ParagPat20/Codes/Documentation/PatentFile.md

# **Design Patent Synopsis for Rollopod – A Transforming Hexapod Robot**

## **Title of the Design**  
**Rollopod – A Transforming Hexapod with Dual-Mode Locomotion**

## **1st Applicant Information**  
- **Name:** Parag Patil  
- **Address:** 10-C, Aakarpark Society, Near Parth colony, Vijalpore, Navsari, Gujarat, India - 396445  
- **Contact Details:** 9313552445  

## **2nd Applicant Information**  
- **Name:** Rutu Patel  
- **Address:** 10-C, Aakarpark Society, Near Parth colony, Vijalpore, Navsari, Gujarat, India - 396445  
- **Contact Details:** 9313552445  

## **Field of Invention**  
The present design pertains to robotic locomotion systems, specifically a **hexapod robot capable of dual-mode movement – walking and rolling** – with a **unique transformation mechanism**. The design enables efficient **mobility, stability, and adaptability**, making it suitable for applications in **search and rescue, planetary exploration, industrial inspection, military operations, and autonomous mobility solutions**.  

Rollopod is not a spherical robot. It is a dual-ring transformable hexapod with a central suspended body where three legs on each side transform into a wheel.

## **Physical Architecture**
Rollopod consists of:
- One central body module.
- Three legs on each side transform into a wheel.
- Three articulated legs mounted on the left ring.
- Three articulated legs mounted on the right ring.
- Six legs total.

The rolling rings remain visible in all operating modes.
The central body remains suspended between the two rolling rings.
The robot never transforms into a sphere.

## **Transformation Mechanism**

Walking Mode:
- Six legs fully extended.
- Three legs on each side.
- Robot operates as a hexapod.

Rolling Mode:
- Left legs fold into left rolling ring.
- Right legs fold into right rolling ring.
- Folded legs become part of the rolling structure.
- Two rolling rings provide locomotion.

During transformation:
- Central body remains visible.
- Central body remains suspended.
- No spherical enclosure is formed.

### Transformation States
Rollopod can exist in:

1. **Walking State**
   - All six legs deployed.

2. **Rolling State**
   - Both side rings closed.

3. **Transitional State**
   - One or more legs partially folded.
   - One ring may be deployed while the opposite ring remains closed.
   - Intermediate configurations are mechanically valid and visually important.

## **Description of the Design**  
The **Rollopod** features a **six-legged walking system** integrated with a **rotational mechanism** that enables the robot to transition smoothly between rolling and walking. The unique **geometric configuration of its legs, outer disk, and actuators** allows a **compact dual-ring rolling configuration for rolling** and an **expanded form for hexapod walking**. The design also incorporates **speed differential control** for movement direction during rolling mode.  

### **Key Novel Design Features**  
1. **Transformation Mechanism:**  
   - Uses a **servo-actuated unfolding system** to switch modes dynamically.  

2. **Aesthetics and Structural Form:**  
   - The **symmetrical leg arrangement** ensures both **walking stability** and **rolling efficiency**.  
   - **Outer disk structure** facilitates smooth rolling motion while maintaining a sleek robotic profile.  

3. **Speed Differential Control for Rolling Movement:**  
   - The design employs **independent speed control of the rolling disks** to enable **forward, backward, and directional movement** without additional steering components.  

4. **Material and Build Innovation:**  
   - **Lightweight aluminum or carbon fiber** frame enhances durability while reducing energy consumption.  
   - **Integrated gear, servo mechanisms, and distributed electronics (ESP32 microcontrollers and PCA9685 PWM drivers)** ensure seamless wireless actuation within the rolling disk while maintaining a compact and efficient form.  

### Structural Novelty
The Rollopod architecture consists of:
- Three legs on each side transform into a wheel.
- One central suspended body.
- Three articulated legs integrated into each rolling ring.

The transformation mechanism allows the legs to fold into the side rolling rings while maintaining visibility of the central body.
The robot maintains a dual-ring geometry throughout transformation and operation.

## **Statement of Novelty**  
The **Rollopod's** design is a **first-of-its-kind robotic structure** integrating **hexapod walking with a rolling transformation system**, while maintaining an **aesthetically distinct and functionally efficient form**. The **side-ring rolling configuration, servo-actuated transformation mechanism, and speed differential movement control** contribute to its **unique and non-obvious design elements**.  

## **Claimed Design Aspects**  
1. **Overall Shape and Transformation Design** – The **unique ability to shift from a hexapod to a dual-wheel rolling robot** while maintaining **functional stability and aesthetics**.  
2. **Leg Mechanism Integration** – A **foldable six-legged system** that fully retracts into a **circular rolling frame**, forming a **streamlined and compact appearance**.  
3. **Rolling Frame with Integrated Actuation** – A **servo-driven disk system** providing **seamless and controlled rolling movement** using **speed differential for directional control**.  
4. **Overall Structural Appearance** – A distinctive **dual-mode robotic form**, aesthetically optimized for both mobility and durability.  

## **Illustrations & Views**  
Attached to this application are **detailed drawings, CAD models, and exploded views** showcasing:  
1. **Isometric View of the Hexapod Mode**  
2. **Isometric View of the Rolling Mode**  
3. **Front, Side, and Top Views of Both Configurations**  
4. **Transformation Sequence Diagrams**  
5. **Functional Component Integration with Structural Elements**  
6. **Additional Views and Uploaded Files:**  
   - All Views  
   - Front View  
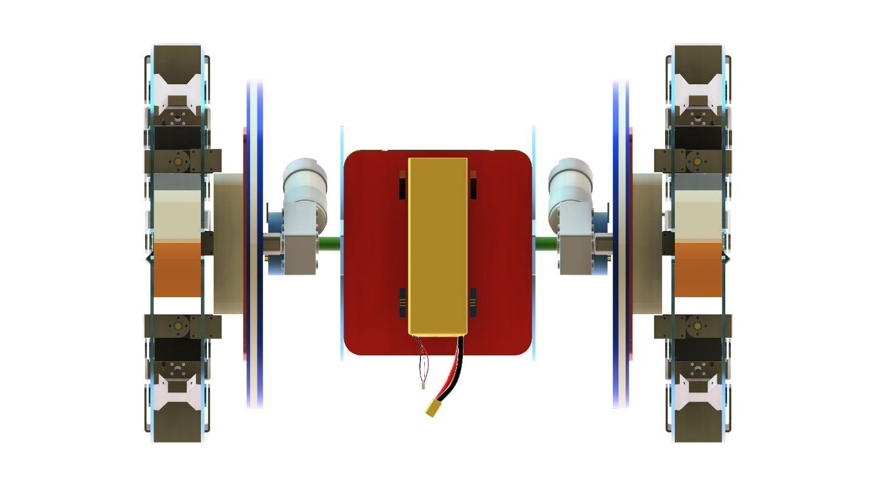
[picture p5: BottomView.png]
Bottom View
   -   
   - Left View  
   - Right View  
   - Home View  

## **Conclusion**  
This **design patent application for Rollopod** seeks protection for its **unique dual-mode robotic structure**, ensuring exclusive rights over its **visual and structural innovations**. The design presents a **novel aesthetic and functional combination** that enhances **robotic mobility across varied terrains and applications**.
