ParagPat20/Codes/Hardware_Design/KiBee/KiBee_V0_Documentation.docx

KiBee V0

Compact AI Home Robot

Product & Engineering Documentation

Version 0.1 • July 2026 • Derived from the Rollopod Platform

# 1. Overview

KiBee V0 is a compact AI home robot derived from Rollopod’s rolling-mode architecture. Instead of transforming into a walking hexapod, KiBee permanently remains in the dual-wheel rolling configuration, creating a smaller, faster, quieter, and more practical indoor companion robot.

It is essentially the first consumer product built on the Rollopod platform.

KiBee inherits the core mechanical advantages of Rollopod’s suspended central body and dual independently driven rolling rings while eliminating the complexity, weight, cost, and maintenance associated with legged transformation. The result is a highly reliable, low-cost indoor mobility platform optimised for AI interaction, voice assistance, and autonomous navigation inside homes, offices, schools, and laboratories.

# 2. Core Philosophy

Instead of designing a robot with legs, take Rollopod’s rolling mode and redesign it as a home robot.

Key advantages of this approach:

- Extremely stable – low centre of gravity and wide dual-wheel base
- High speed indoors on flat surfaces (tiles, wood, carpet)
- Simple mechanics – no transformation linkages or multi-DOF leg joints
- Lower manufacturing cost and bill of materials
- Lower power consumption and longer battery life
- Much higher reliability than legged or multi-mode robots

# 3. Relationship with Rollopod

KiBee is not a separate mobility concept. It is a direct derivative of Rollopod’s rolling architecture:

- Rollopod: Dual-mode robot (walking + rolling) for outdoor, rough-terrain, disaster-response, and research applications.
- KiBee: Permanently configured in Rollopod’s rolling mode, optimised for indoor environments, human interaction, and AI assistance.

This approach lets KiBee inherit Rollopod’s compact suspended-body geometry, stability, differential-drive rolling mechanism, and proven bearing isolation concept while removing the entire walking transformation subsystem. The same engineering DNA therefore serves two distinct product lines: a rugged field research platform (Rollopod) and a consumer indoor companion (KiBee).

# 4. Mechanical Architecture

## 4.1 Chassis

KiBee uses a fixed dual-ring rolling chassis derived directly from Rollopod’s rolling state:

- Two side rolling rings (permanently closed configuration)
- Central suspended body / payload pod
- Precision bearing interfaces isolating the body from ring rotation
- Same balancing and low-centre-of-gravity concept as Rollopod
- No walking transformation – legs are never deployed

The robot never deploys legs. The rolling rings are permanent structural wheels, not transformed leg assemblies. This dramatically simplifies the mechanical design, reduces part count, and improves long-term reliability for continuous indoor use.

## 4.2 Locomotion

Primary locomotion is dual independently driven wheels with differential steering:

- Two DC geared motors, one per ring
- Differential drive enabling forward, reverse, and zero-radius turning
- Suitable for tiles, wooden floors, offices, homes, schools, and laboratories
- Quiet, smooth, and energy-efficient continuous motion

## 4.3 Central Body

The central suspended body houses all major electronics and interaction components:

- Raspberry Pi 5 (main AI & navigation computer)
- Battery pack and power management
- Speakers and microphone array
- Camera (vision / face detection / navigation)
- Display (status / facial expressions / UI)
- IMU, sensors, and secondary controller (ESP32)

The body remains suspended between the two wheels exactly as in Rollopod, preserving the stable, forward-facing sensor and interaction orientation at all times.

# 5. Appearance & Industrial Design

KiBee is designed as a friendly, compact, rounded consumer electronics product rather than an industrial or research prototype.

Visual and emotional targets:

- Friendly and approachable
- Compact and low-profile
- Rounded soft forms
- Consumer electronics aesthetic (not industrial or military)
- Emotional reference mix: Samsung Ballie + Amazon Astro + Loona, but mechanically grounded in Rollopod’s dual-ring geometry

The industrial design prioritises safety for household use (no sharp edges, soft contact surfaces where possible) while retaining the distinctive dual-wheel silhouette that communicates stability and mobility.

# 6. Electronics Architecture

## 6.1 Main Processor – Raspberry Pi 5

The Raspberry Pi 5 serves as the high-level brain responsible for:

- AI inference and conversational assistance
- Computer vision (navigation, face detection, obstacle awareness)
- Audio processing and voice interaction
- User interface and display rendering
- Networking (Wi-Fi, remote control, cloud services)

## 6.2 Secondary Controller – ESP32

A dedicated ESP32 handles real-time, safety-critical, and low-level tasks:

- Motor control (PWM / driver interface)
- Battery monitoring and power management
- IMU reading and basic orientation feedback
- Encoder feedback (if fitted)
- Safety interlocks and emergency stop logic

This distributed architecture mirrors the reliable master/slave + real-time actuator separation proven on Rollopod, adapted for a simpler two-motor indoor platform.

## 6.3 Mobility Hardware

Two DC geared motors with appropriate motor drivers, an IMU for tilt and motion sensing, and optional wheel encoders form the complete mobility subsystem. Power is distributed with isolation between logic and high-current motor rails, following the same reliability principles established on the Rollopod platform.

# 7. KiBee V0 Feature Set

The initial V0 release focuses on core indoor companion capabilities:

Feature | Description
Autonomous Movement | Self-directed navigation on flat indoor surfaces with obstacle awareness
AI Assistant | On-device and/or cloud-assisted conversational AI for general help, reminders, and information
Voice Interaction | Far-field microphone array and speaker system for natural voice commands and responses
Indoor Navigation | Map building / localisation suitable for homes, offices, and classrooms
Remote Control | App or web-based remote operation and monitoring

# 8. Target Environments & Use Cases

KiBee V0 is optimised for controlled indoor environments:

1. Homes – family companion, elderly assistance, pet monitoring, smart-home hub
2. Offices – visitor greeting, meeting-room assistance, delivery of small items
3. Schools & Laboratories – educational platform, interactive learning companion
4. Retail / hospitality – customer guidance and information (future expansion)

# 9. Development Status (V0)

KiBee V0 is the first consumer-oriented product derived from the mature Rollopod mechanical and control research. Current status emphasises:

Completed / Inherited

- Dual-ring rolling geometry and suspended-body concept (from Rollopod)
- Differential-drive motor architecture principles
- Distributed control philosophy (high-level Pi + real-time ESP32)

In Progress / V0 Focus

- Consumer-grade enclosure and industrial design
- Raspberry Pi 5 software stack (AI, vision, voice, navigation)
- Simplified two-motor drive electronics and battery system
- Safety certification and indoor usability testing

# 10. Summary

KiBee V0 represents the first commercialisation path of the Rollopod platform. By permanently locking the robot into its most efficient locomotion mode—dual-wheel differential rolling—and wrapping that proven geometry in a friendly consumer form factor with modern AI capabilities, KiBee delivers a practical, reliable, and cost-effective indoor companion robot.

The project maintains a clear technical lineage: Rollopod’s research into hybrid locomotion and suspended-body stability directly enables KiBee’s simplicity and robustness. Future iterations can continue to share mechanical and control IP between the outdoor research platform and the indoor consumer product line.

KiBee V0 – Rollopod’s rolling heart, reborn as a home companion.

Document Control

Title: KiBee V0 – Product & Engineering Documentation

Version: 0.1 (Initial)

Date: July 2026

Derived from: Rollopod Platform (Parag Patil • Rutu Patel • Parul University)

Status: Living document – update as mechanical and software prototypes progress

Confidential • Page • Derived from Rollopod Platform

KiBee V0 | Product & Engineering Documentation
