ParagPat20/Codes/Documentation/Photos.docx

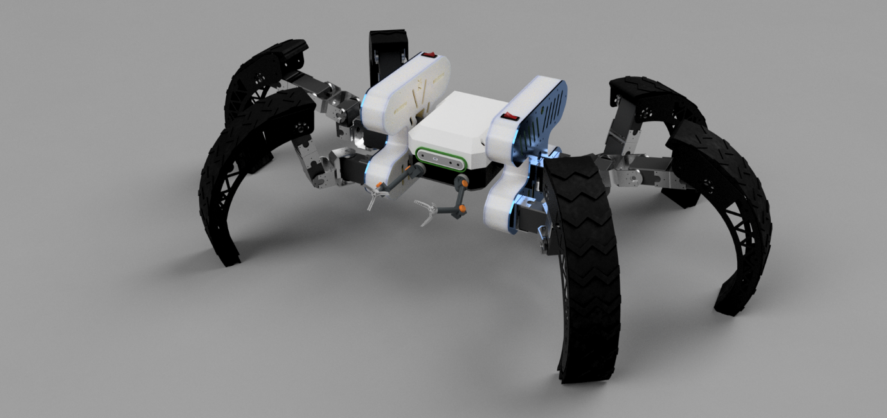
[picture p44: figure]
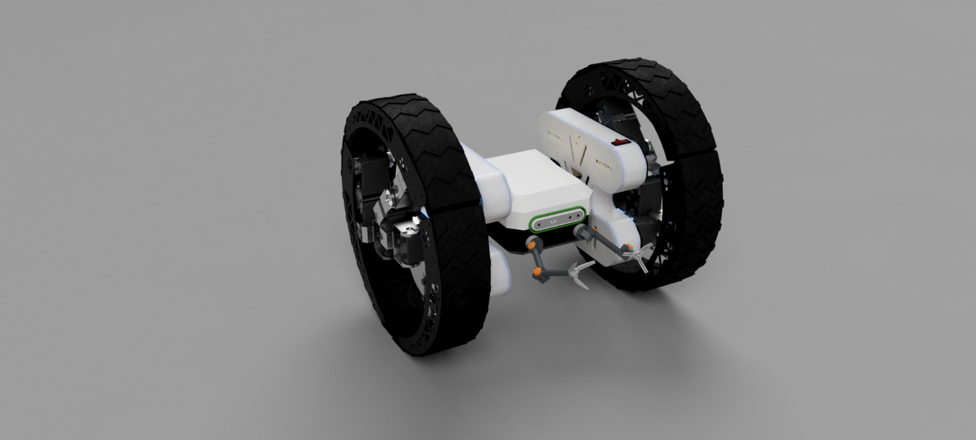
[picture p45: figure]
