ParagPat20/Codes/Firmware/LCD_1_69_BASE/source.gif

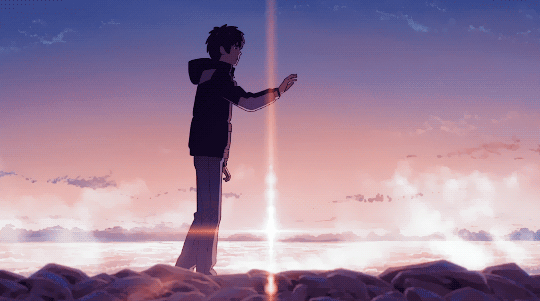
Firmware/LCD_1_69_BASE/source.gif
