ParagPat20/Codes/Hardware_Design/KiBee/7c71ced0-1b35-460e-97a9-f4f10c7d7b67.png

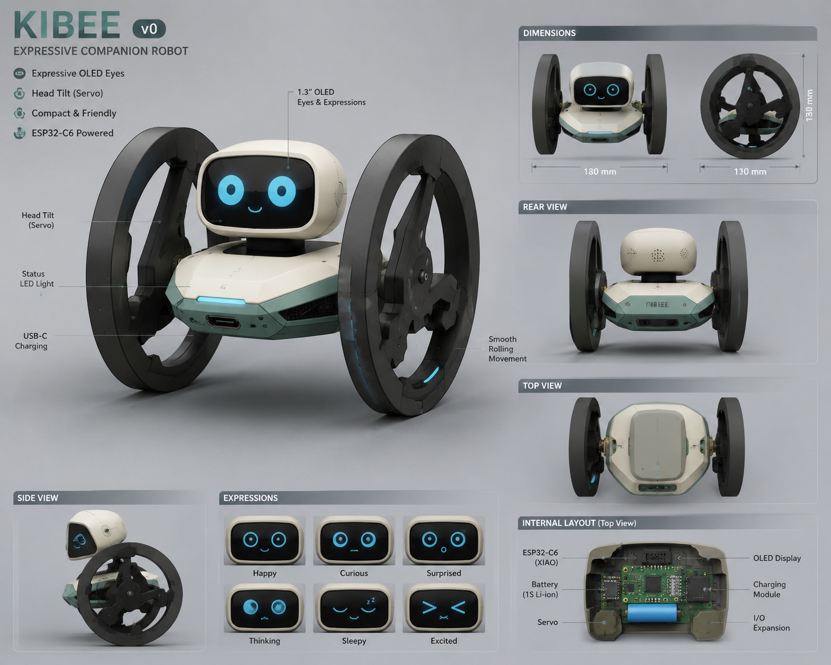
Hardware_Design/KiBee/7c71ced0-1b35-460e-97a9-f4f10c7d7b67.png
