ParagPat20/Codes/Hardware_Design/KiBee/51fc863d-131d-4990-9c5d-91c019468618.png

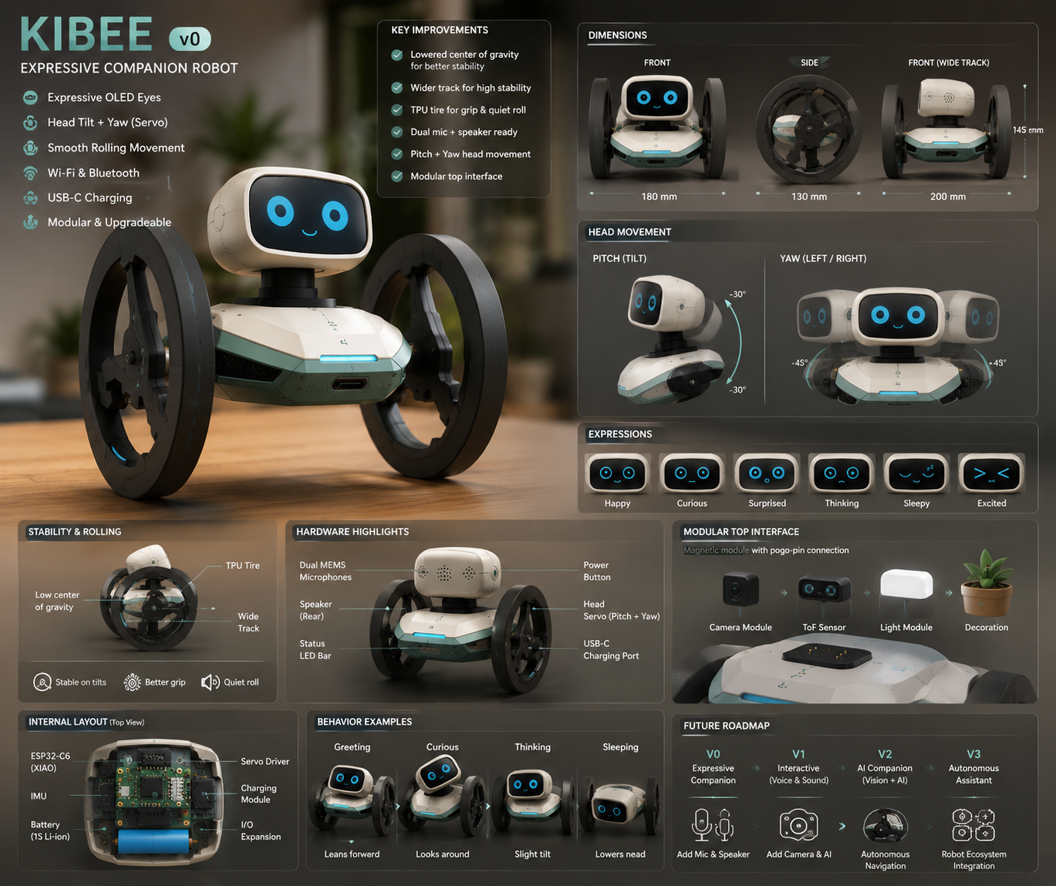
Hardware_Design/KiBee/51fc863d-131d-4990-9c5d-91c019468618.png
