ParagPat20/Codes/Hardware_Design/KiBee/FrontVierw.png

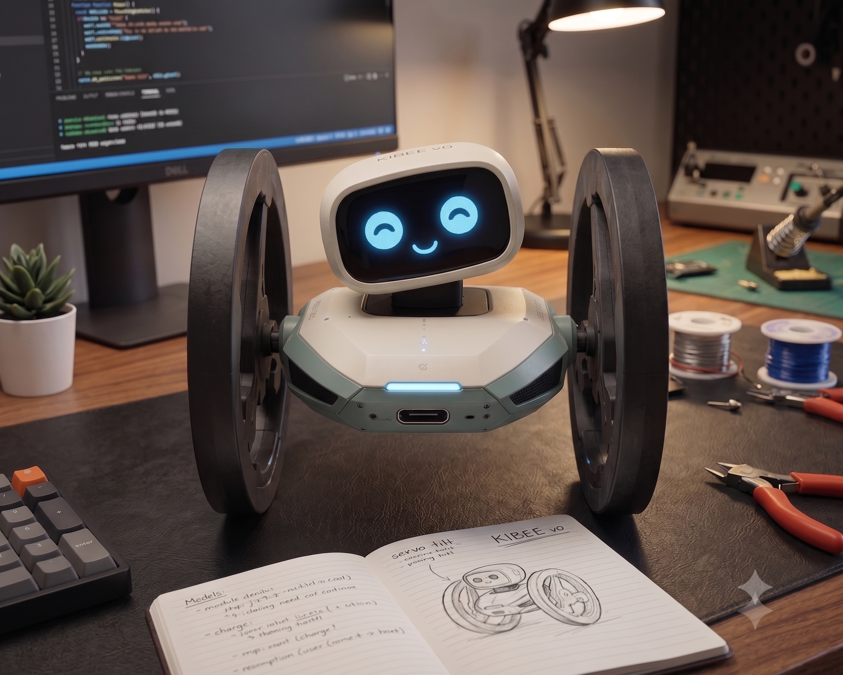
Hardware_Design/KiBee/FrontVierw.png
