ParagPat20/Codes/Hardware_Design/KiBee/Gemini_Generated_Image_ich2xvich2xvich2.png

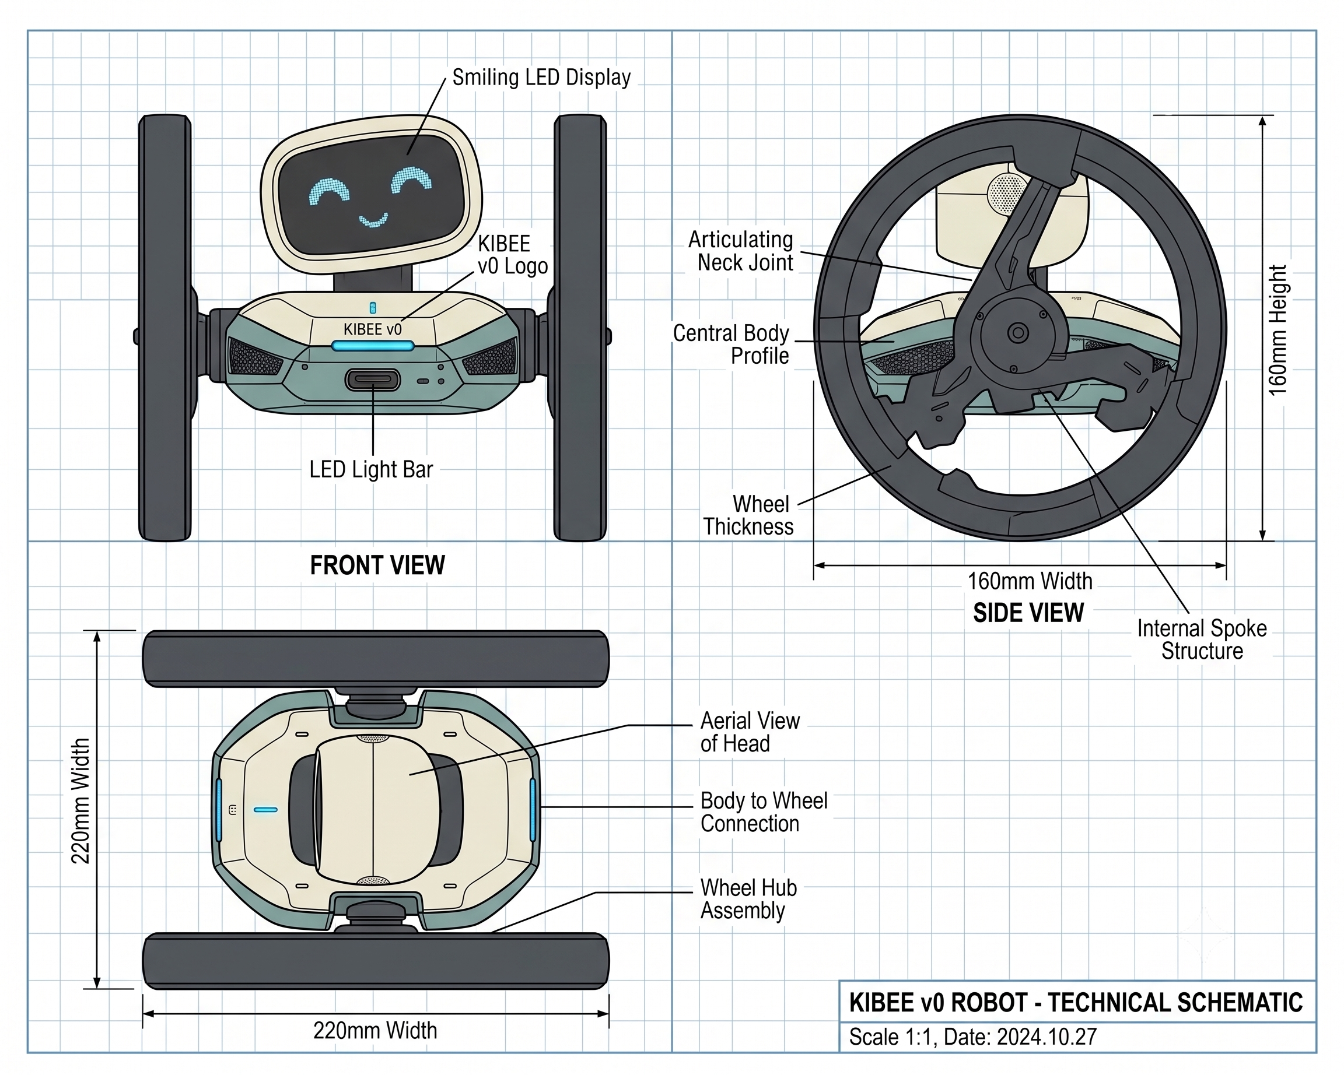
Hardware_Design/KiBee/Gemini_Generated_Image_ich2xvich2xvich2.png
