ParagPat20/Codes/Hardware_Design/KiBee/Gemini_Generated_Image_mz15chmz15chmz15.png

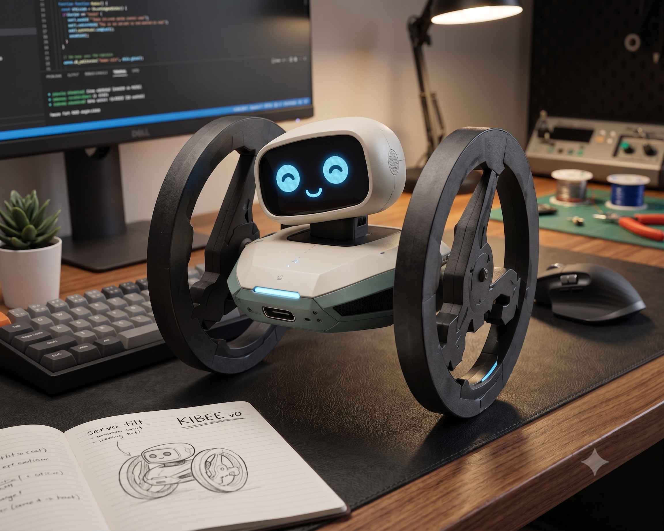
Hardware_Design/KiBee/Gemini_Generated_Image_mz15chmz15chmz15.png
