ParagPat20/Codes/Hardware_Design/KiBee/SideView.png

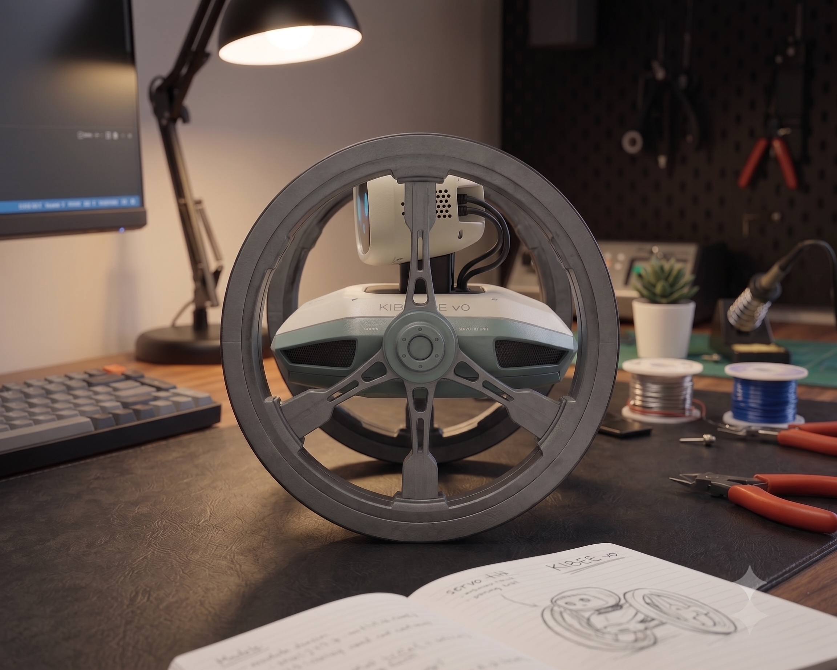
Hardware_Design/KiBee/SideView.png
