ParagPat20/Codes/Hardware_Design/KiBee/TopView.png

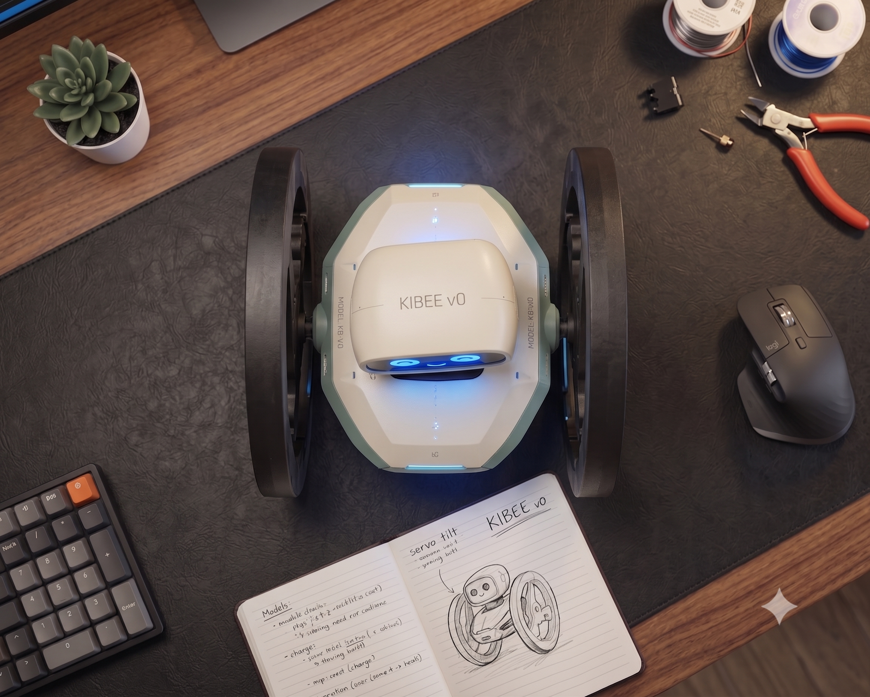
Hardware_Design/KiBee/TopView.png
