ParagPat20/Codes/Hardware_Design/Schematics/PCB_PCB_Rollopod_2_2026-06-08.png

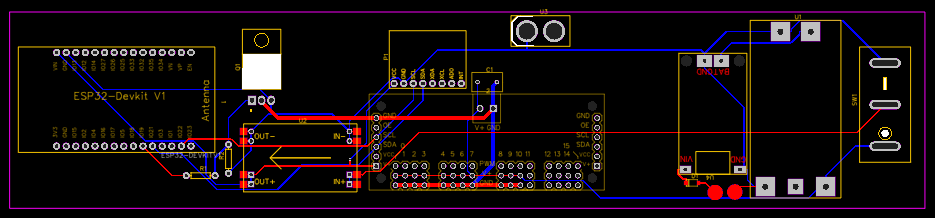
Hardware_Design/Schematics/PCB_PCB_Rollopod_2_2026-06-08.png
