ParagPat20/Codes/Hardware_Design/Schematics/Schematic_Rollopod_2026-06-08.png

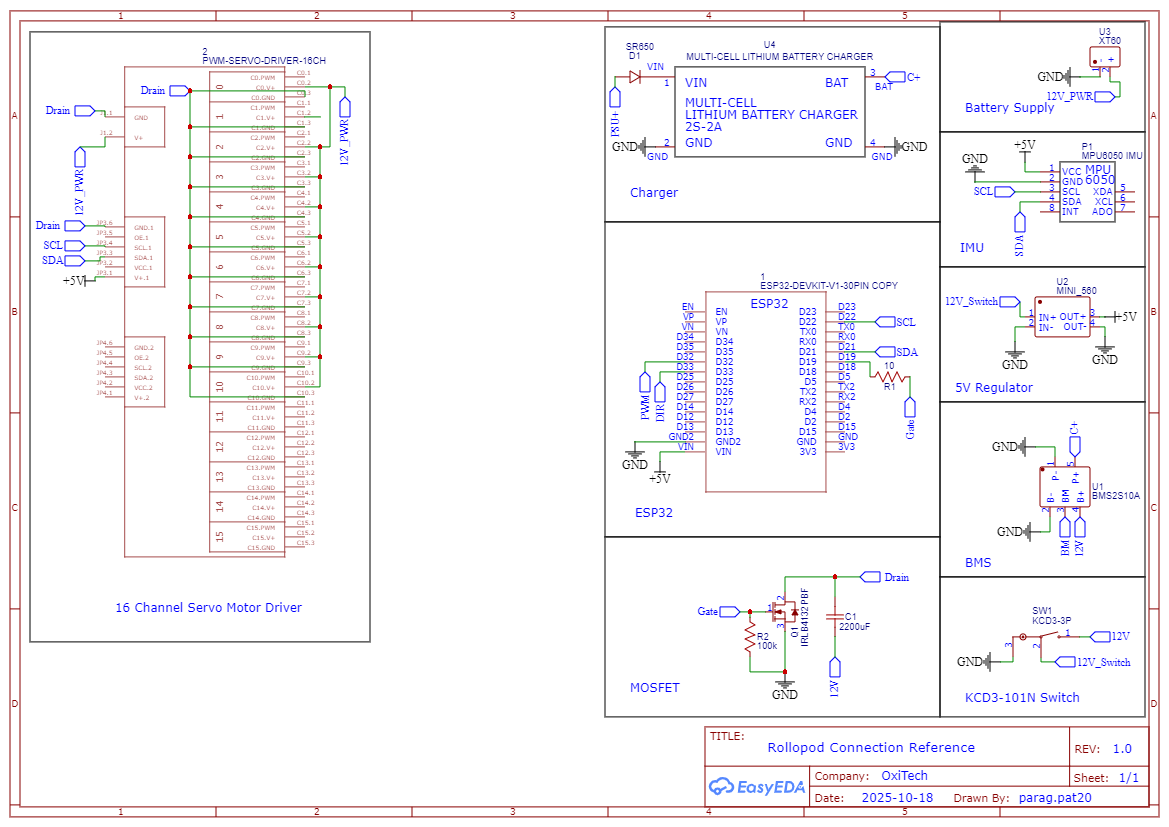
Hardware_Design/Schematics/Schematic_Rollopod_2026-06-08.png
