ParagPat20/Codes/Scripts/extracted_images/image7.jpg

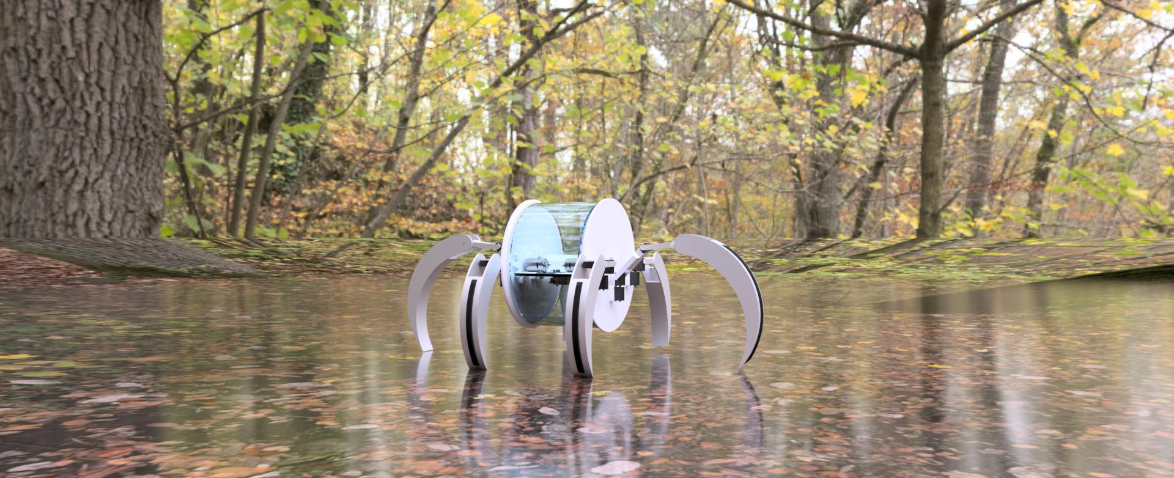
Scripts/extracted_images/image7.jpg
