ParagPat20/Codes/Scripts/extracted_images/image9.jpg

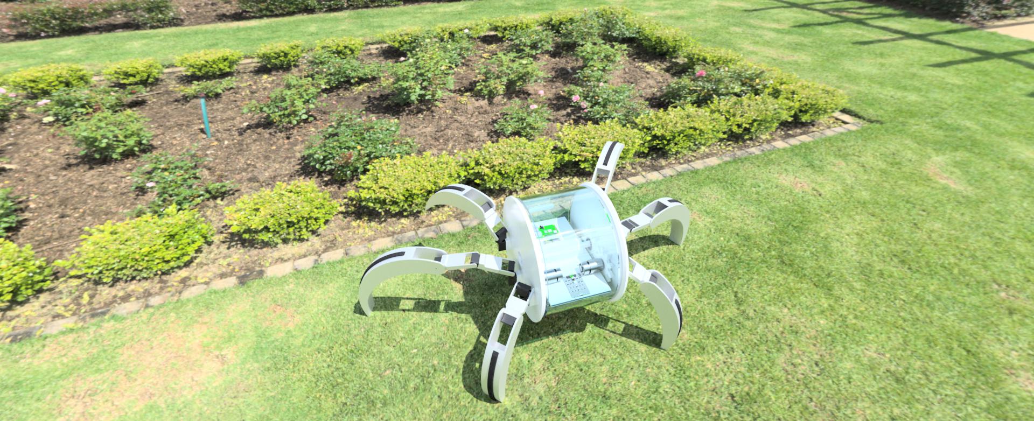
Scripts/extracted_images/image9.jpg
