ParagPat20/Codes/Scripts/extracted_images/image10.png

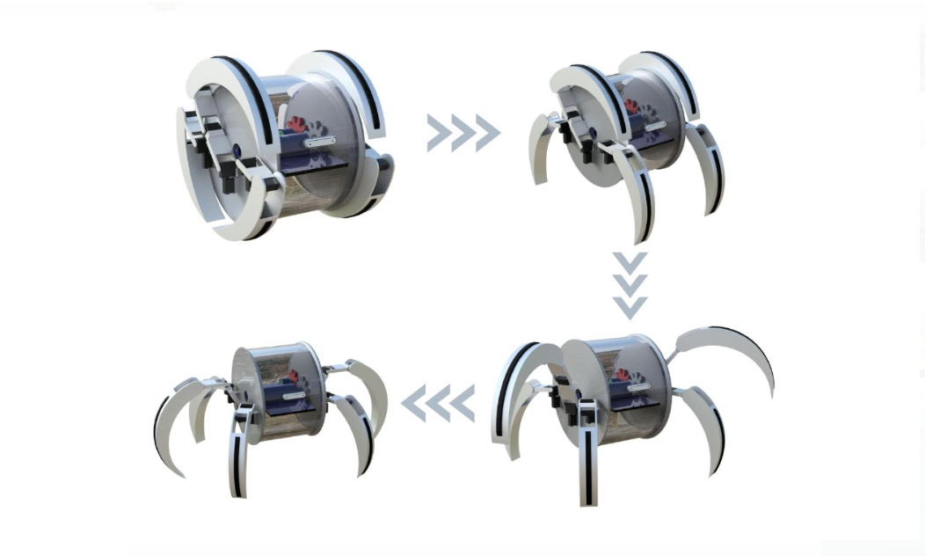
Scripts/extracted_images/image10.png
