ParagPat20/Codes/Scripts/extracted_images/image11.jpg

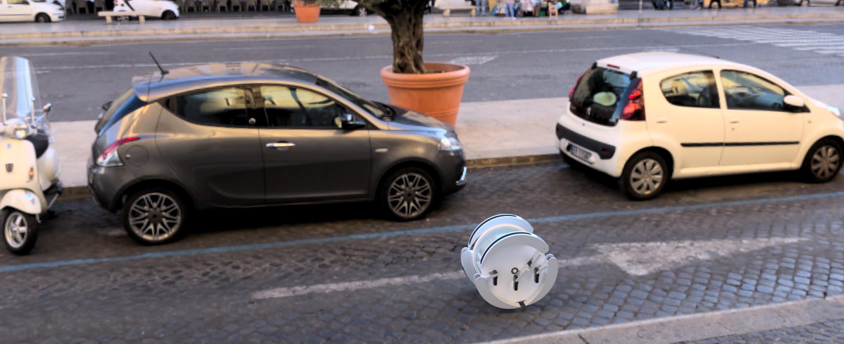
Scripts/extracted_images/image11.jpg
