ParagPat20/Codes/Scripts/extracted_images/image12.png

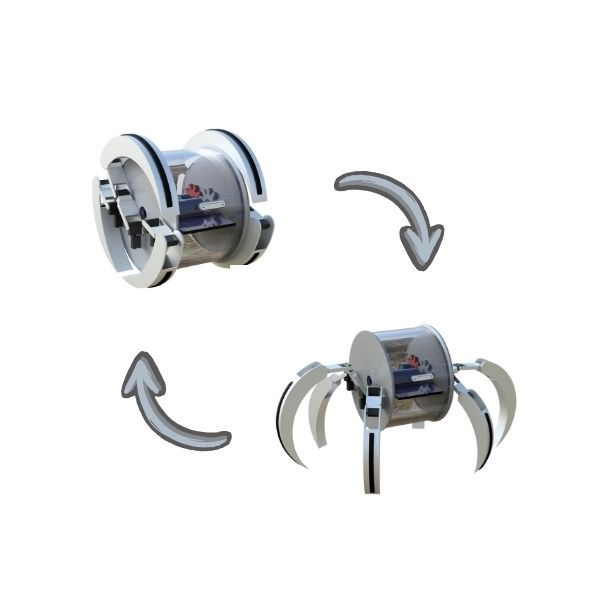
Scripts/extracted_images/image12.png
