ParagPat20/Codes/Scripts/extracted_images/image14.png

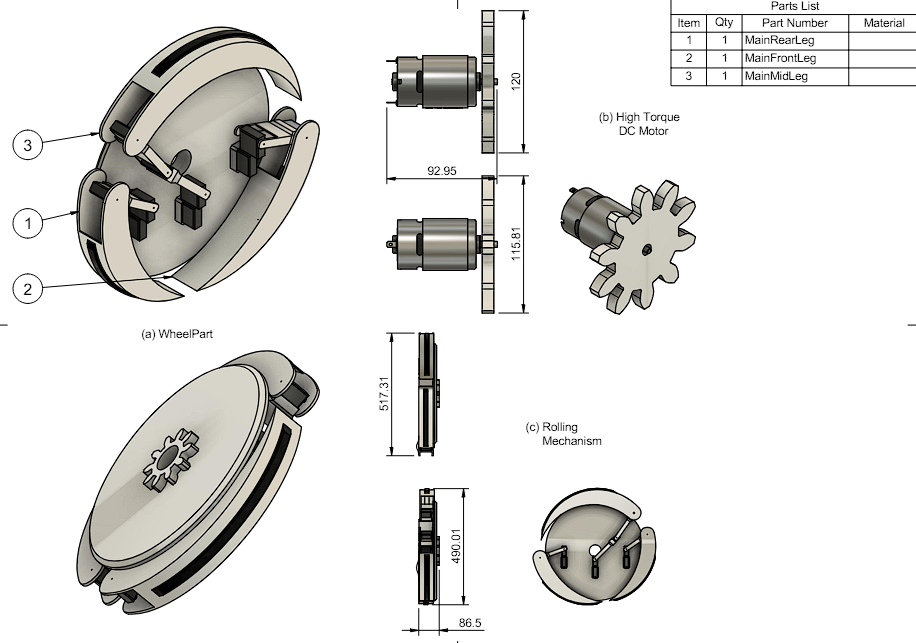
Scripts/extracted_images/image14.png
