ParagPat20/Codes/Scripts/extracted_images/image15.jpg

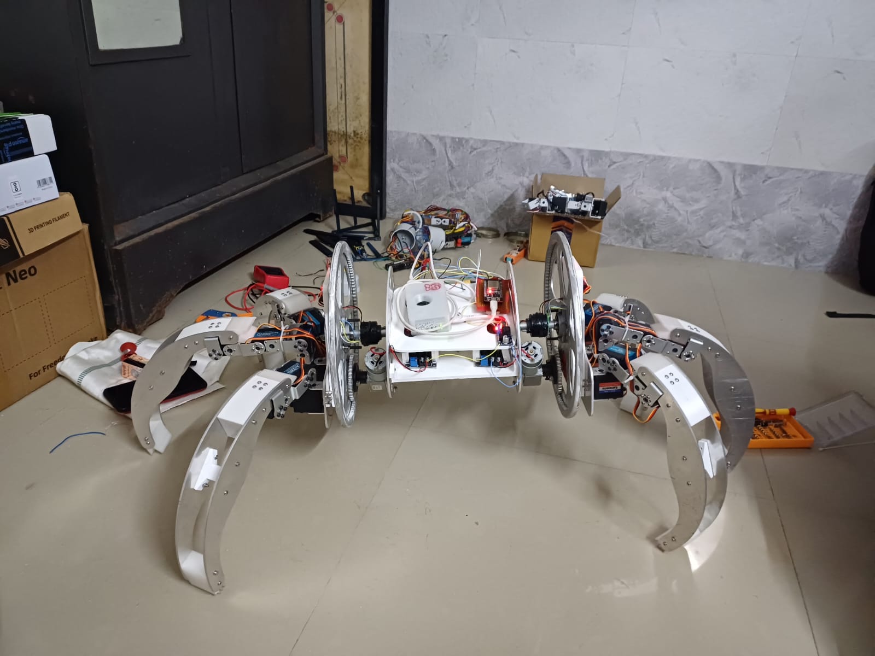
Scripts/extracted_images/image15.jpg
