ParagPat20/Codes/Scripts/extracted_images/image16.gif

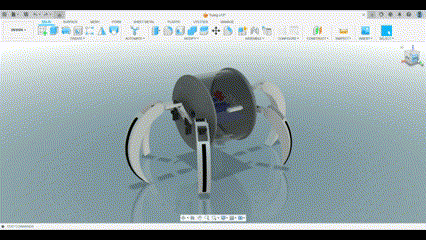
Scripts/extracted_images/image16.gif
