ParagPat20/Codes/Scripts/extracted_images/image17.gif

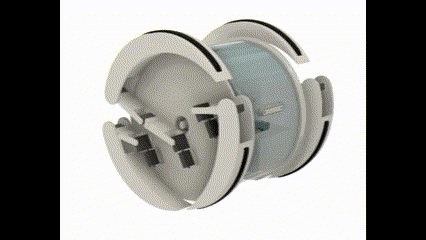
Scripts/extracted_images/image17.gif
