ParagPat20/Codes/Scripts/extracted_images/image18.png

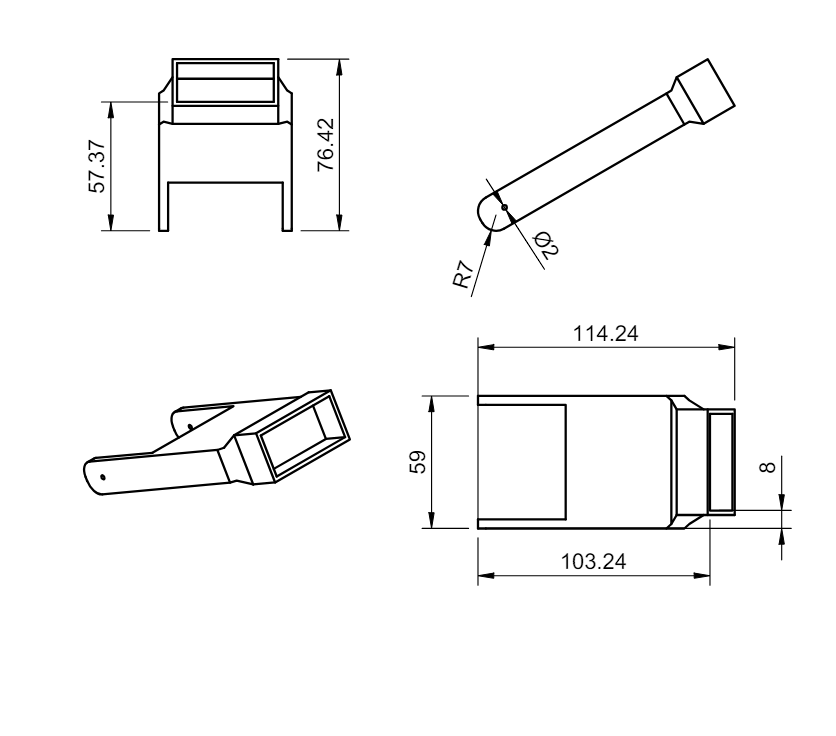
Scripts/extracted_images/image18.png
