ParagPat20/Codes/Scripts/extracted_images/image19.png

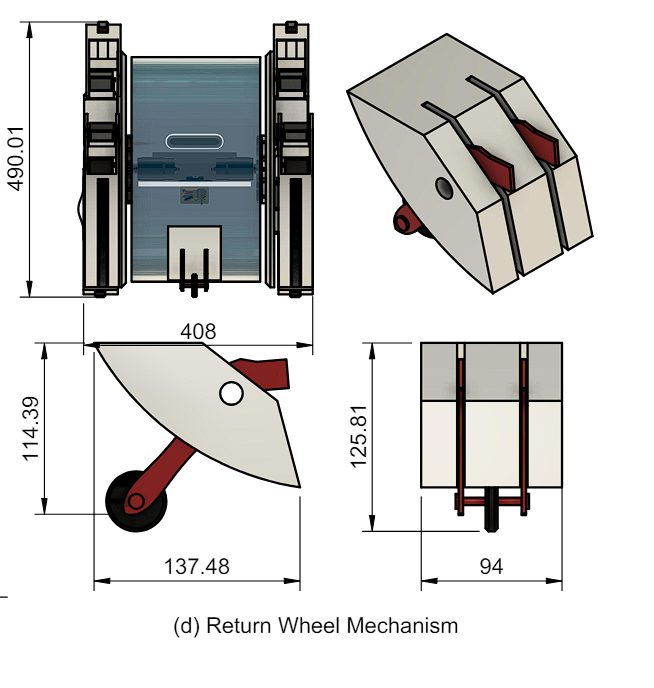
Scripts/extracted_images/image19.png
