ParagPat20/Codes/Scripts/extracted_images/image21.png

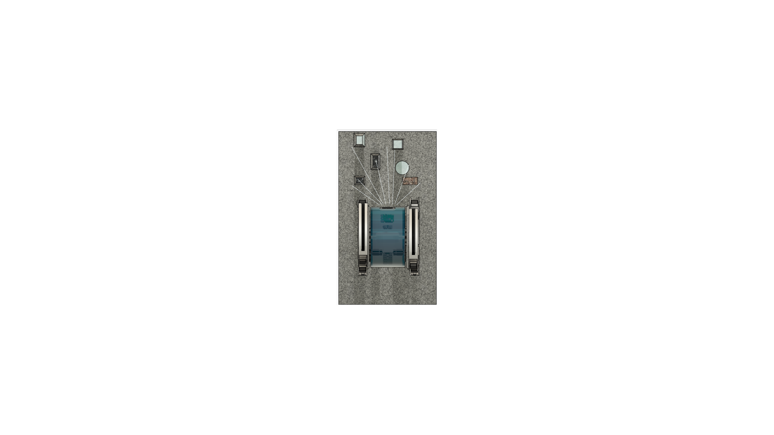
Scripts/extracted_images/image21.png
