ParagPat20/Codes/Scripts/extracted_images/image22.png

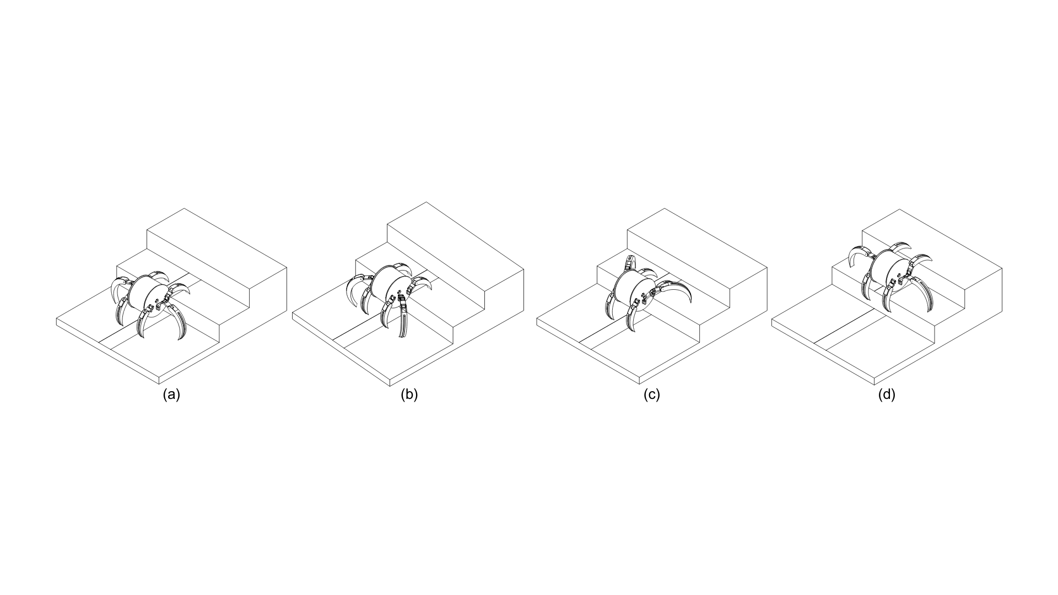
Scripts/extracted_images/image22.png
