ParagPat20/Codes/Scripts/extracted_images/image24.png

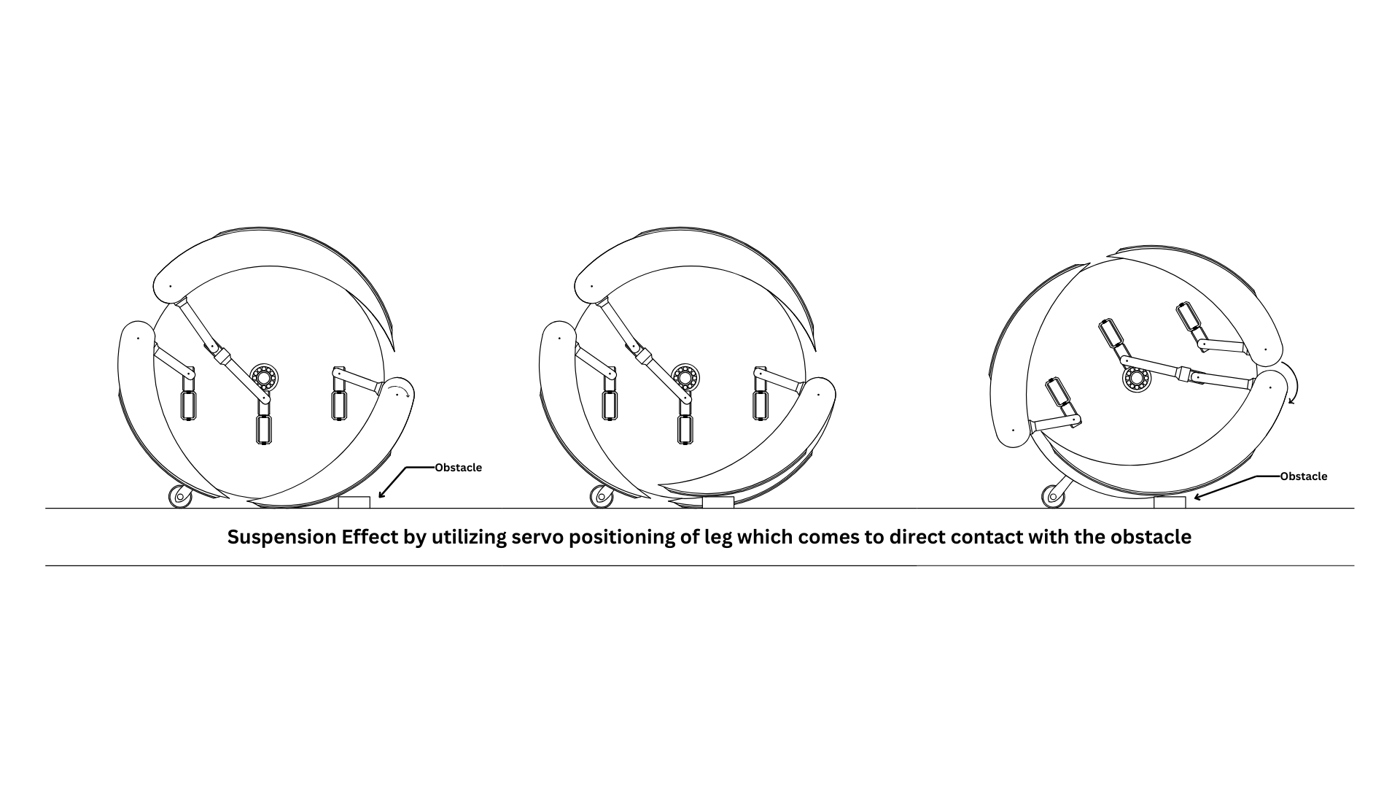
Scripts/extracted_images/image24.png
