ParagPat20/Codes/Scripts/extracted_images/image25.png

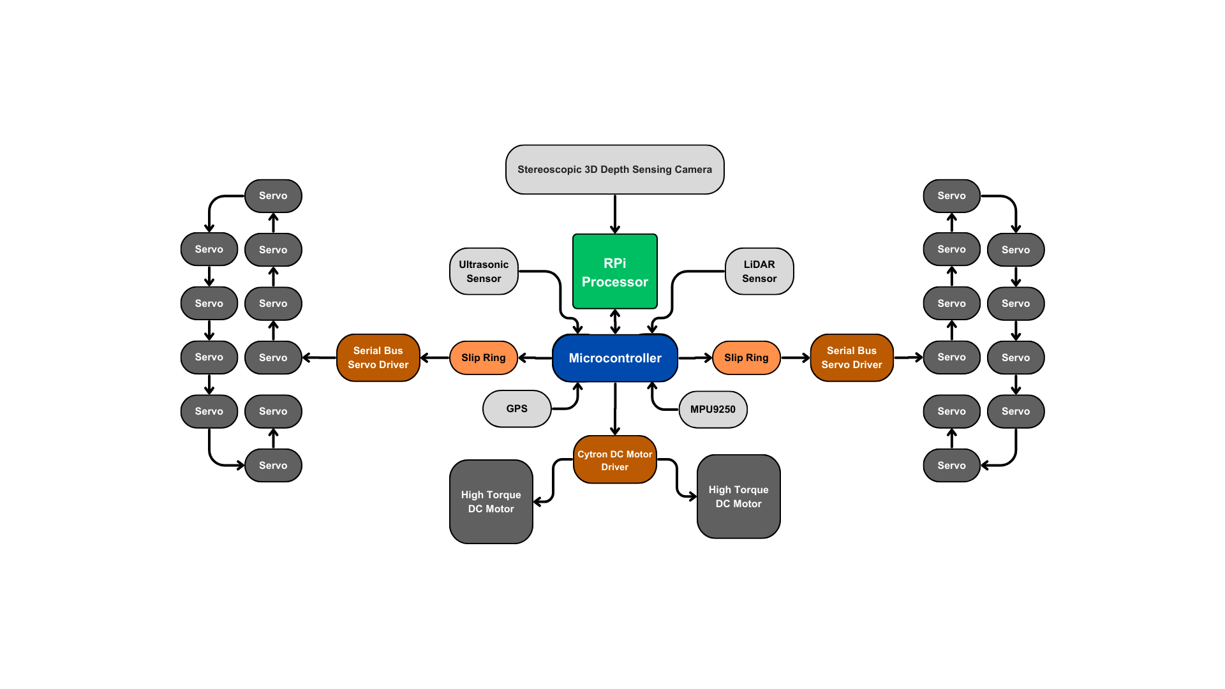
Scripts/extracted_images/image25.png
