ParagPat20/Codes/Hardware_Design/KiBee/CostSheets.xlsx

Sheet: AeroBee
Product | Qty | OWNED | Q1 |  | Q2 |  | Q3 |  | Selection | Final Total
 |  |  | Link | Amount | Link | Amount | Link | Amount
Flight Controller Stack | 1 | TRUE | Robu.in (https://robu.in/product/35a-4in1-esc-f4-v3s-plus-flight-control-v3-5-v3-s-built-in-image-filtering-osd/) | ₹7847 | Robocraze (https://robocraze.com/products/hglrc-specter-f460-electronic-stack-with-4-in-1-esc) | ₹9429 | HitechXYZ (https://hitechxyz.in/products/speedybee-f405-v4-bls-60a-30x30-flight-controller-esc-stack-for-fpv-drone) | ₹7499 | Q1 | ₹7847
Servo | 2 | TRUE | Evelta (https://evelta.com/ft90m-6v-2-3kg-cm-280deg-digital-servo-motor/) | ₹256 | Robocraze (https://robocraze.com/products/mg90s-servo-motor) | ₹125 | Robokits (https://robokits.co.in/motors/rc-servo-motor/mg90s-semi-metal-gear-servo-motor-9g-premium) | ₹102 | Q1 | ₹512
BLDC Motor | 4 | TRUE | Evelta (https://evelta.com/rs2205-2300kv-ccw-brushless-motor/) | ₹625 | Evelta (https://evelta.com/2205-2300kv-3-4s-cw-ccw-brushless-motor/) | ₹835 | HitechXYZ (https://hitechxyz.in/products/rs2205-2300kv-cw-brushless-motor-for-5-inch-fpv-racing-drone) | ₹549 | Q1 | ₹2500
OpenHD Companion Computer | 1 | TRUE | Evelta (https://evelta.com/raspberry-pi-zero-2-w/) | ₹1749 | Robu (https://robu.in/product/raspberry-pi-3-model-a/) | ₹2865 |  |  | Q1 | ₹1749
OpenHD Video Reciever | 1 | TRUE | Robu (https://robu.in/product/raspberry-pi-5-model-8gb/) | ₹19618 |  |  |  |  | Q1 | ₹19618
Wifi module | 2 | FALSE | Robokits (https://robokits.co.in/iot-wireless-solutions/wireless-serial-modules/rtl8812au-usb-long-range-ac1200-wifi-module-for-openipc) | ₹1161 | HubTronics (https://hubtronics.in/BL-M8812EU2) | ₹1849 | Amazon (https://www.amazon.in/gp/product/B0859M539M/ref=ox_sc_act_title_7?smid=AJ6SIZC8YQDZX&th=1) | ₹1849 | Q2 | ₹3698 | Pending
Antenna | 4 |  | QuartzComponents (https://quartzcomponents.com/products/2-4ghz-5g-12dbi-dual-band-wifi-antenna-with-rp-sma-male-connector) | ₹185 | Robocraze (https://robocraze.com/products/6dbi-2-4ghz-duck-antenna-sma-male) | ₹157 |  |  | Q1 | ₹740 | Pending
8mm Bearing | 4 | TRUE | Flyrobo (https://www.flyrobo.in/radial-ball-bearing-608zz-for-3d-printer) | ₹21 | Robocraze (https://robocraze.com/products/radial-ball-bearing-608zz-for-3d-printer) | ₹39 | Robu (https://robu.in/product/606zz-bearing-6x17x6-stainless-steel-shielded-miniature-bearings/) | ₹62 | Q1 | ₹84
8mm Rod | 2 | TRUE | Robu (https://robu.in/product/pultruded-carbon-fibre-tube-hollow-8mm-6mm-1000mm/) | ₹626 |  |  |  |  | Q1 | ₹1252
10mm Bearing | 2 | TRUE | QuartzComponents (https://quartzcomponents.com/products/6000-zz-metal-double-shielded-miniature-ball-bearings10mm-x-26mm-x-8mm-robotics) | ₹23 | OnlyScrews (https://onlyscrews.in/products/6000-2rs-rubber-sealed-ball-bearing-10x26x8) | ₹18 |  |  | Q1 | ₹46
10mm Rod | 2 | TRUE | Robu (https://robu.in/product/carbon-fiber-tube-hollow10mmod8mmid330mml-twill/) | ₹1000 |  |  |  |  | Q1 | ₹2000
Propellers | 1 | TRUE | Robu (https://robu.in/product/orange-hd-51433-hurricane-pc-3-blade-propellers-2cw2ccw-skitzo-galaxy/) | ₹161 | HiTechXYZ (https://hitechxyz.in/products/gemfan-51433-hurricane-pc-3-blade-propellers-skitzo-galaxy-2cw-2ccw) | ₹319 | RCMumbai (https://rcmumbai.com/products/gf-51466l-moonlight-led-props-white-no-accessories) | ₹139 | Q1 | ₹161
Brass-Inserts | 50 | TRUE | OnlyScrews (https://onlyscrews.in/products/m3-x-5mm-3d-printing-brass-threaded-inserts-dia-3mm-length-5mm) | ₹4.6 |  |  |  |  | Q1 | ₹230
XT60 | 1 | TRUE | Robu (https://robu.in/product/xt60h-connector-with-housing-male/) | ₹29 | Flyrobo (https://www.flyrobo.in/xt60_male_female_bullet_connector_plug) | ₹27 | Robokits (https://robokits.co.in/batteries-chargers/accessories/plugs-and-connectors/amass-xt60e-m-mountable-xt60-male-plug) | ₹45 | Q2 | ₹27
UBEC | 1 | TRUE | ZBotic (https://zbotic.in/product/ubec-5v-7a/) | ₹425 | Robu (https://robu.in/product/ubec-5v-7a/) | ₹492 | Flyrobo (https://www.flyrobo.in/readytosky-5v-7a-ubec) | ₹445 | Q1 | ₹425
Battery | 1 | TRUE | Robokits (https://robokits.co.in/batteries-chargers/drone-batteries/genx-power-premium-lipo-battery/genxpower-14.8v-lipo-batteries/genx-14.8v-4s-2200mah-40c-80c-premium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) | ₹1865 |  |  |  |  | Q1 | ₹1865
TOTAL |  |  |  |  |  |  |  |  |  | ₹42754
Vendors
Robu (http://robu.in/)
Flyrobo (http://flyrobo.in/)
Robokits (http://robokits.in/)
Evelta (http://evelta.com/)
ZBotic (https://zbotic.in/)
Robocraze (https://robocraze.com/)
IndianRoboStore (https://indianrobostore.com/)
ThinkRobotics (http://thinkrobotics.com/)
RobotSkull (https://www.robotskullindia.com/)
UAV Marketplace (http://www.uavmarketplace.in/)
QuadKart (http://quadkart.in/)
KTron (https://www.ktron.in/)
OnlyScrews (https://onlyscrews.in/)
Quartz Components (https://quartzcomponents.com/)
Amazon (http://amazon.in/)
Thingbits (http://thingbits.in/)
Prompt
Product:
Must check Features:
Strictly search on these Stores:
Robu, Flyrobo, Robokits, Evelta, ZBotic, Robocraze, IndianRoboStore, ThinkRobotics, RobotSkullUAV, Marketplace, QuadKart, KTron, Thingbits, OnlyScrews, Quartz Components, Amazon
Budget:

Sheet: Rollopod
Product | Qty | OWNED | Q1 |  | Q2 |  | Q3 |  | Selection | Final Total
 |  |  | Link | Amount | Link | Amount | Link | Amount
High Torque Servo Motors | 20 | TRUE | RoboticsDNA (https://roboticsdna.in/product/servo-150kg-rds51150-270degree-metal-gear-digital-servo-motor-arduino-high-torque/) | ₹3278 |  |  |  |  | Q1 | ₹65560
DC Motor | 2 | TRUE | Robokits (https://robokits.co.in/motors/rhino-ig32-12v-20w-dc-motors/dc-servo-encoder-12v-motor/rhino-100rpm-25kgcm-12v-dc-planetary-geared-quad-encoder-servo-motor) | ₹1850 | Robokits (https://robokits.co.in/motors/ig45-12v-50w-dc-geared-motor/ig45-12v-50w-encoder-servo-motor/industrial-grade-ig45-planetary-dc-geared-encoder-servo-motor-50w-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) | ₹3650 | Robu (https://robu.in/product/pro-range-planetary-gear-dc-motor-12v-96rpm-121-7-n-cm-pg36m555-50-9k-with-encoder-me-377ppr/) | ₹2260 | Q1 | ₹3700
ESP32 DevKit Module | 4 | TRUE | ZBotic (https://zbotic.in/product/esp-wroom-32-wifi-bluetooth-development-board/) | ₹378 | Robocraze (https://robocraze.com/products/nodemcu-32-wifi-bluetooth-esp32-development-board30-pin) | ₹383 | Flyrobo (https://www.flyrobo.in/esp32-development-board-with-type-c-and-ch340) | ₹389 | Q3 | ₹1556
PCA9685 Servo Driver | 3 | TRUE | Robocraze (https://robocraze.com/products/pca9685-16-channel-servo-motor-driversoldered) | ₹219 | Robokits (https://robokits.co.in/development-board/motor-control-boards/rc-servo-controller/pca9685-16-channel-12-bit-pwm-servo-driver-i2c-compatible-with-arduino) | ₹205 | Flyrobo (https://www.flyrobo.in/16_channel_pwm_servo_motor_driver_i2c_module) | ₹258 | Q1 | ₹657
Buck Converter | 4 | TRUE | Flyrobo (https://www.flyrobo.in/mini-360-dc-dc-buck-converter-step-down-module) | ₹30 | Robokits (https://robokits.co.in/power-supply/dc-dc-power-supply/mini360-rc-power-supply-step-down-module) | ₹49 |  |  | Q1 | ₹120
Switch | 5 | TRUE | Flyrobo (https://www.flyrobo.in/kcd1-101-2pin-boat-rocker-switch) | ₹3 | Robocraze (https://robocraze.com/products/rocker-switch-16a-250v-spdt-3pin-red-led-3) | ₹22 |  |  | Q1 | ₹15
XT60 | 6 | TRUE | Robu (https://robu.in/product/xt60h-connector-with-housing-male/) | ₹29 | Flyrobo (https://www.flyrobo.in/xt60_male_female_bullet_connector_plug) | ₹27 | Robokits (https://robokits.co.in/batteries-chargers/accessories/plugs-and-connectors/amass-xt60e-m-mountable-xt60-male-plug) | ₹45 | Q1 | ₹174
PerfBoard | 3 | TRUE | Flyrobo (https://www.flyrobo.in/9-x-15-cm-double-side-universal-pcb-prototype-board) | ₹96 |  |  |  |  | Q1 | ₹288
4S Li-ion 5200mAh | 1 | TRUE | Robokits (https://robokits.co.in/batteries-chargers/drone-batteries/genx-power-premium-lipo-battery/genxpower-14.8v-lipo-batteries/genx-14.8v-4s-5200mah-40c-80c-premium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) | ₹3295 | Robu (https://robu.in/product/samsung-inr-21700-50s-14-8v-5000mah-4s1p/) | ₹2499 |  |  | Q2 | ₹2499
3S Lipo 6000mAh | 2 | TRUE | Robokits (https://robokits.co.in/batteries-chargers/drone-batteries/genx-power-premium-lipo-battery/genxpower-11.1v-lipo-batteries/genx-11.1v-3s-6800mah-40c-80c-premium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) | ₹3275 | Robu (https://robu.in/product/orange-11-1v-6200mah-3s-40c-lipo-battery-pack-xt60-connector/) | ₹5384 |  |  | Q1 | ₹6550
BMS | 3 | TRUE | Flyrobo (https://www.flyrobo.in/3s-20a-li-ion-18650-bms-lithium-battery-protection-board) | ₹91 |  |  |  |  | Q1 | ₹273
Battery Charger | 3 | TRUE |  |  |  |  |  |  | Q1 | ₹0
Voltage Monitor | 3 | TRUE |  |  |  |  |  |  | Q1 | ₹0
IMU Sensor | 3 | TRUE |  |  |  |  |  |  | Q1 | ₹0
Capacitors | 10 | TRUE |  |  |  |  |  |  | Q1 | ₹0
Knurled Brass inserts | 50 | TRUE |  |  |  |  |  |  | Q1 | ₹0
TOTAL |  |  |  |  |  |  |  |  |  | ₹81392
EXTRAS:
Threadlocker
Solder
Heat Shrink
Connectors
Crimp Terminals
JST Connectors
XT60 Pairs
Aluminium Sheet
Carbon Fiber Plate
Carbon Fiber Tube
3D Printed Parts
Heat-set Inserts
Wiring
Sleeving
Zip Ties
Cable Chain

Sheet: KiBee
Product | Qty | OWNED | Q1 |  | Q2 |  | Q3 |  | Selection | Final Total
 |  |  | Link | Amount | Link | Amount | Link | Amount
ESP32 XIAO | 1 | TRUE |  |  |  |  |  |  | Q1 | ₹0
Microcontroller | 1 | TRUE |  |  |  |  |  |  |  | ₹0
Battery | 1 | FALSE |  |  |  |  |  |  |  | ₹0
DC Motor | 2 | FALSE |  |  |  |  |  |  |  | ₹0
Mic Module | 1 | FALSE |  |  |  |  |  |  |  | ₹0
Speaker Module | 1 | FALSE |  |  |  |  |  |  |  | ₹0
Servo Motor | 4 | FALSE |  |  |  |  |  |  |  | ₹0
RGB LED | 1 | FALSE |  |  |  |  |  |  |  | ₹0
IMU | 1 | FALSE |  |  |  |  |  |  |  | ₹0
Touch Sensor | 3 | FALSE |  |  |  |  |  |  |  | ₹0
Charging Module | 2 | FALSE |  |  |  |  |  |  |  | ₹0
Voltage Regulator | 2 | FALSE |  |  |  |  |  |  |  | ₹0
Display | 1 | FALSE |  |  |  |  |  |  |  | ₹0
ToF | 1 | FALSE |  |  |  |  |  |  |  | ₹0
Pogo Pins | 4 | FALSE |  |  |  |  |  |  |  | ₹0
TOTAL |  |  |  |  |  |  |  |  |  | ₹0

Sheet: FLF
Product | Qty | OWNED | Q1 |  | Q2 |  | Q3 |  | Selection | Final Total
 |  |  | Link | Amount | Link | Amount | Link | Amount
Microcontroller | 1 | FALSE |  |  |  |  |  |  | Q1 | ₹0
MPU6050 | 1 |  |  |  |  |  |  |  | Q1 | ₹0
ESP8266 | 1 |  |  |  |  |  |  |  |  | ₹0
DC Motor | 2 |  |  |  |  |  |  |  |  | ₹0
TB6612 | 1 |  |  |  |  |  |  |  |  | ₹0
Switch | 1 |  |  |  |  |  |  |  |  | ₹0
3S 1000mAh Battery | 1 |  |  |  |  |  |  |  |  | ₹0
8 IR Sensor Array | 1 |  |  |  |  |  |  |  |  | ₹0
TOTAL |  |  |  |  |  |  |  |  |  | ₹0
