ParagPat20/Codes/Reference/mechanism/body_side.STL

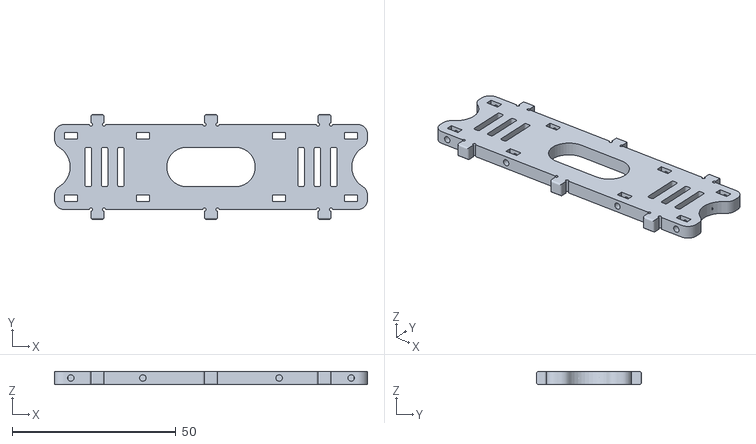
[picture p75: CAD file, 2025-01-12, last stored version]
Reference/mechanism/body_side.STL
95.6 x 32.0 x 4.00
