ParagPat20/Codes/Reference/mechanism/leg_bottom.STL

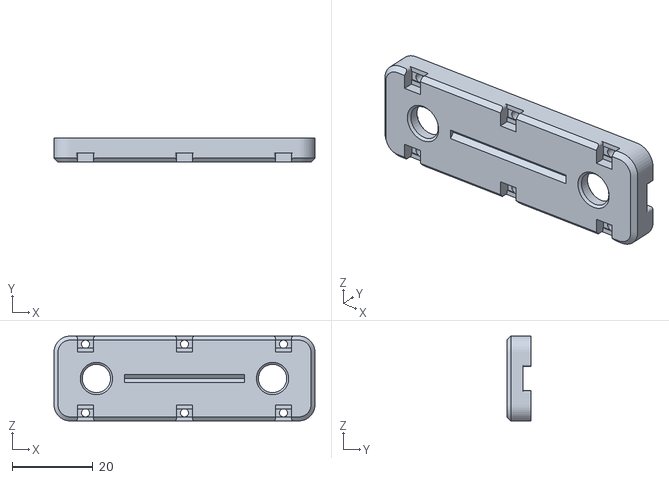
[picture p76: CAD file, 2025-01-12, last stored version]
Reference/mechanism/leg_bottom.STL
64.6 x 6.00 x 21.0
