ParagPat20/Codes/Reference/mechanism/leg_top.STL

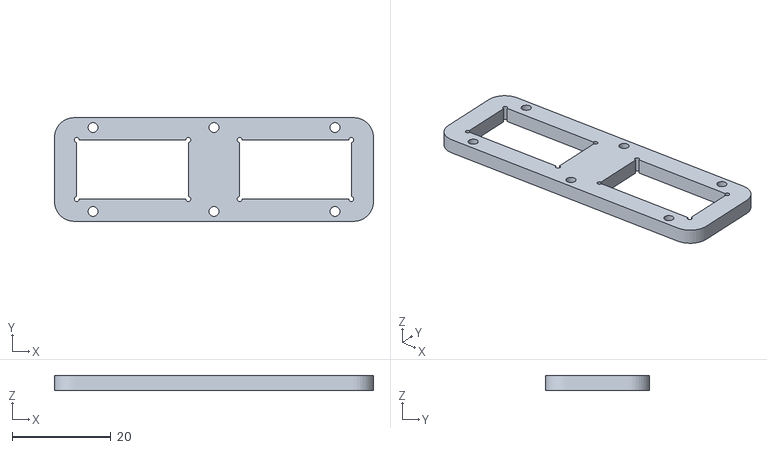
[picture p77: CAD file, 2025-01-12, last stored version]
Reference/mechanism/leg_top.STL
64.6 x 21.0 x 3.00
