ParagPat20/Codes/Reference/mechanism/body_base.STL

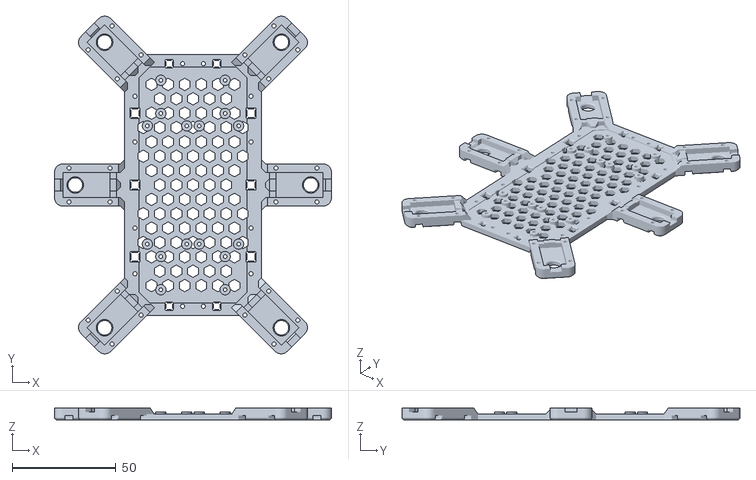
[picture p78: CAD file, 2025-01-12, last stored version]
Reference/mechanism/body_base.STL
133.6 x 162.9 x 6.00
