ParagPat20/Codes/Reference/mechanism/joint_top_mg90s.STL

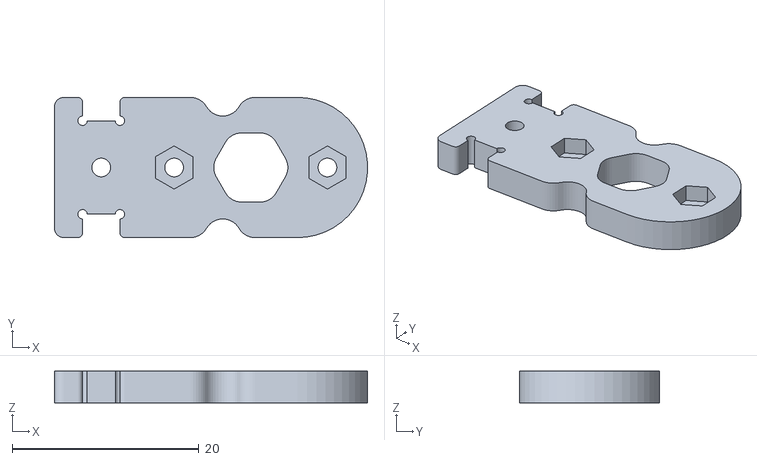
[picture p79: CAD file, 2025-01-12, last stored version]
Reference/mechanism/joint_top_mg90s.STL
33.5 x 15.0 x 3.40
