ParagPat20/Codes/Reference/mechanism/leg_side.STL

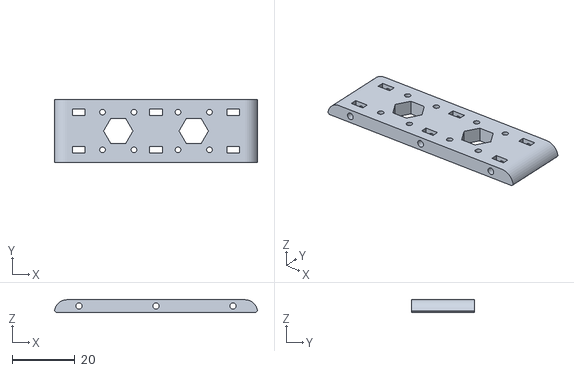
[picture p80: CAD file, 2025-01-12, last stored version]
Reference/mechanism/leg_side.STL
64.5 x 20.0 x 4.00
