ParagPat20/Codes/Reference/mechanism/body_servo_side1.STL

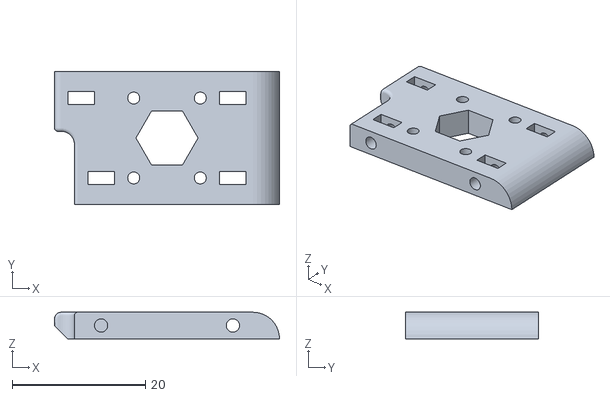
[picture p81: CAD file, 2025-01-12, last stored version]
Reference/mechanism/body_servo_side1.STL
33.8 x 20.0 x 4.00
