ParagPat20/Codes/Reference/mechanism/body_front_back.STL

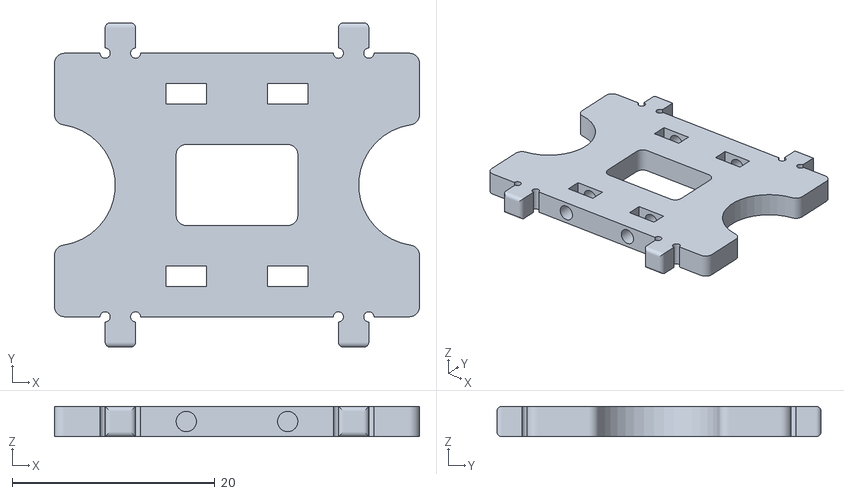
[picture p82: CAD file, 2025-01-12, last stored version]
Reference/mechanism/body_front_back.STL
36.0 x 32.0 x 3.00
