ParagPat20/Codes/Reference/mechanism/accessory_cable_holder.STL

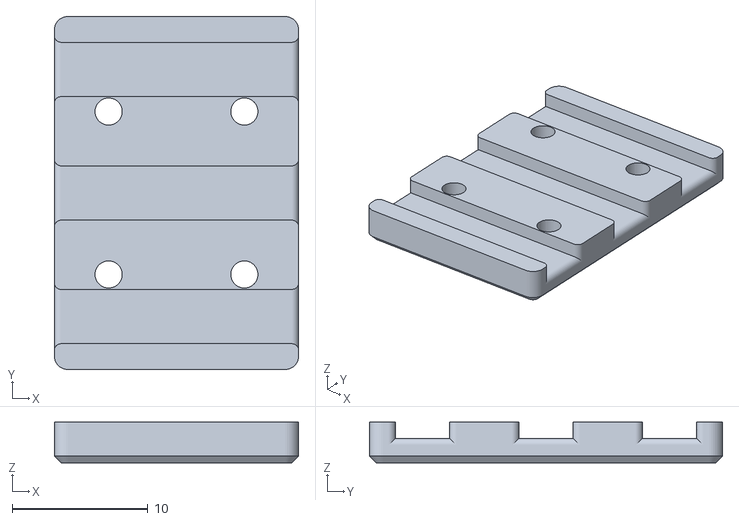
[picture p83: CAD file, 2025-01-12, last stored version]
Reference/mechanism/accessory_cable_holder.STL
18.0 x 26.0 x 3.00
