ParagPat20/Codes/Reference/mechanism/body_battery.STL

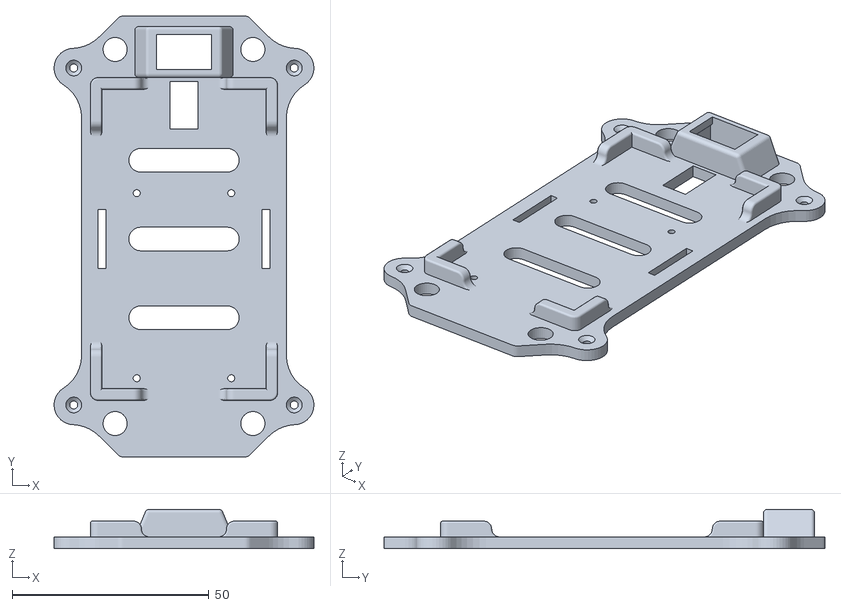
[picture p84: CAD file, 2025-01-12, last stored version]
Reference/mechanism/body_battery.STL
66.0 x 112.0 x 10.0
