ParagPat20/Codes/Reference/mechanism/foot_tip.STL

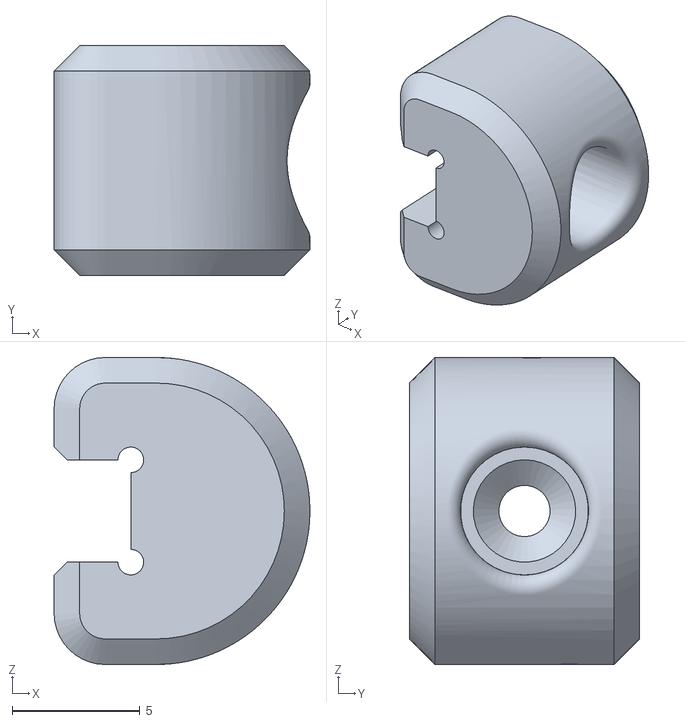
[picture p85: CAD file, 2025-01-12, last stored version]
Reference/mechanism/foot_tip.STL
10.0 x 9.00 x 12.0
