ParagPat20/Codes/Reference/mechanism/foot_ground.STL

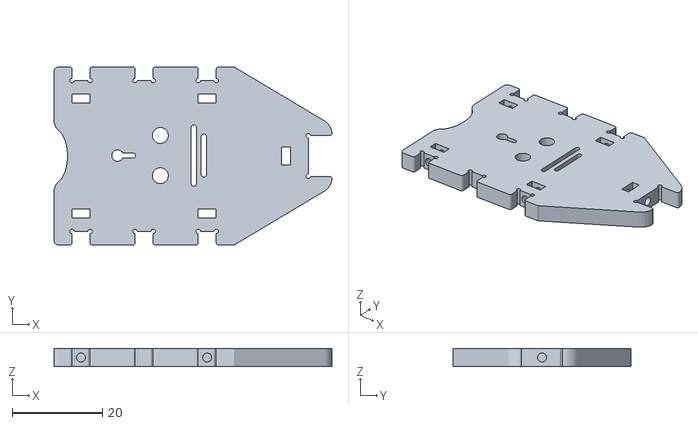
[picture p86: CAD file, 2025-01-12, last stored version]
Reference/mechanism/foot_ground.STL
61.7 x 39.5 x 4.00
