ParagPat20/Codes/Reference/mechanism/foot_top_mg90s.STL

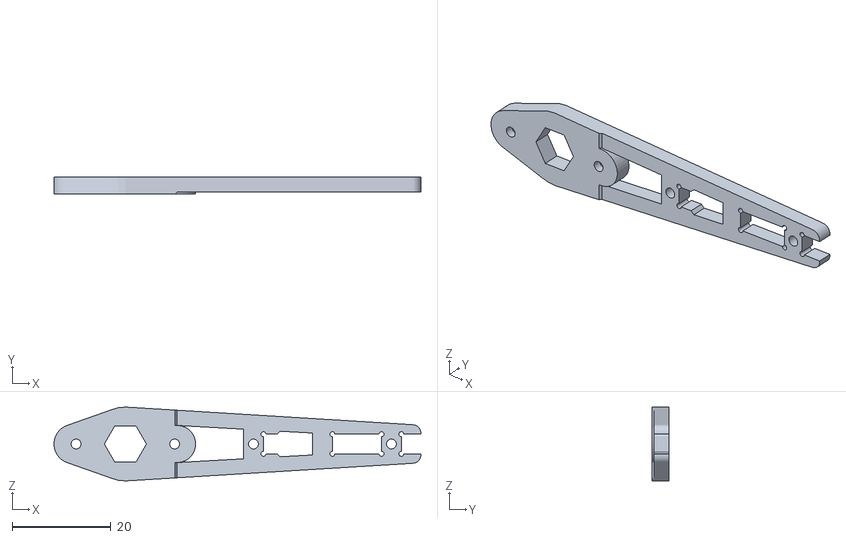
[picture p87: CAD file, 2025-01-12, last stored version]
Reference/mechanism/foot_top_mg90s.STL
74.5 x 3.40 x 15.0
