ParagPat20/Codes/Reference/mechanism/foot_bottom.STL

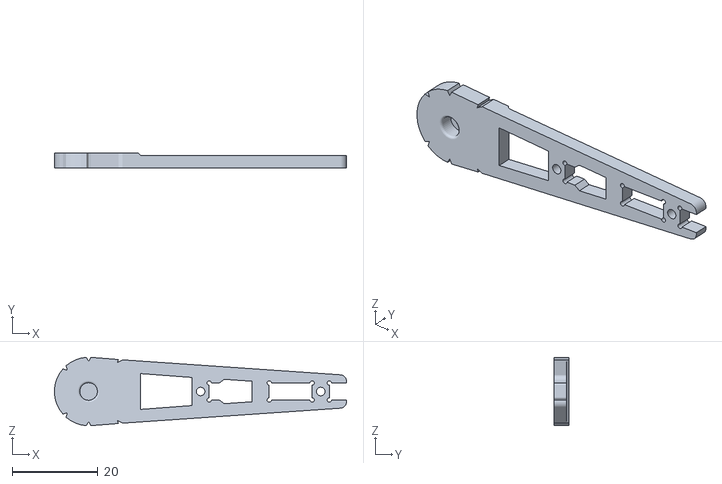
[picture p88: CAD file, 2025-01-12, last stored version]
Reference/mechanism/foot_bottom.STL
68.0 x 3.60 x 15.9
