ParagPat20/Codes/Reference/mechanism/joint_cross.STL

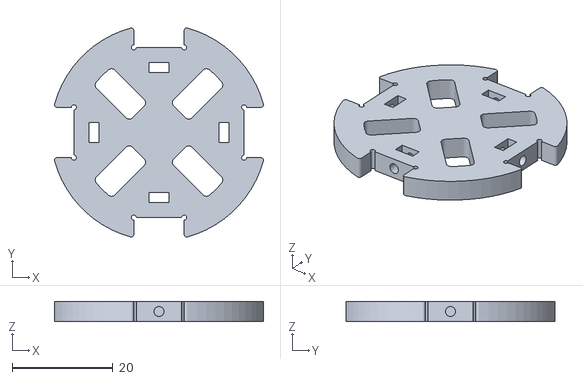
[picture p89: CAD file, 2025-01-12, last stored version]
Reference/mechanism/joint_cross.STL
41.5 x 41.5 x 4.00
