ParagPat20/Codes/Reference/mechanism/body_servo_top.STL

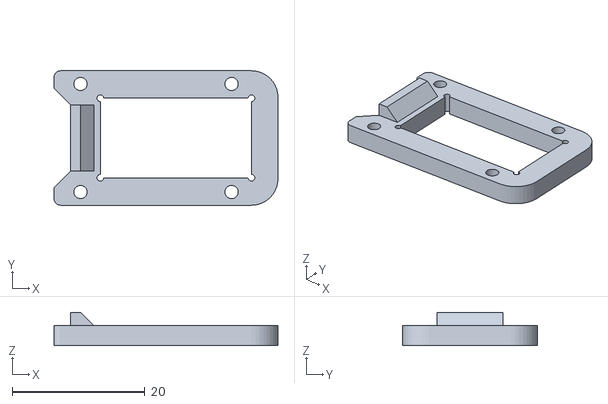
[picture p90: CAD file, 2025-01-12, last stored version]
Reference/mechanism/body_servo_top.STL
33.8 x 20.3 x 5.00
