ParagPat20/Codes/Reference/mechanism/accessory_spacer_mg90s.STL

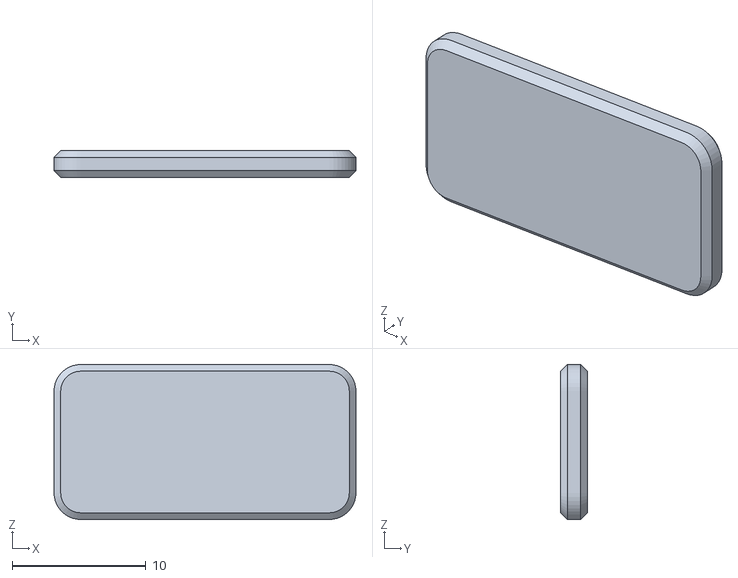
[picture p91: CAD file, 2025-01-12, last stored version]
Reference/mechanism/accessory_spacer_mg90s.STL
22.6 x 2.00 x 11.6
