ParagPat20/Codes/Reference/mechanism/body_top.STL

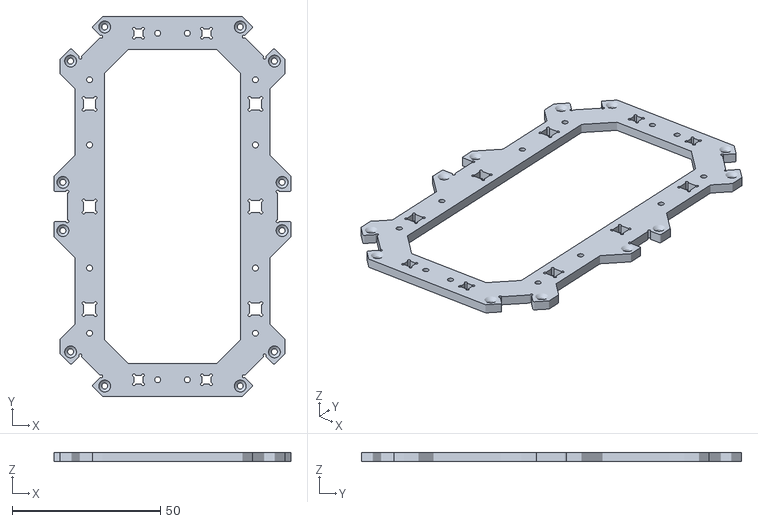
[picture p92: CAD file, 2025-01-12, last stored version]
Reference/mechanism/body_top.STL
80.0 x 128.3 x 3.00
