ParagPat20/Codes/Reference/mechanism/joint_bottom.STL

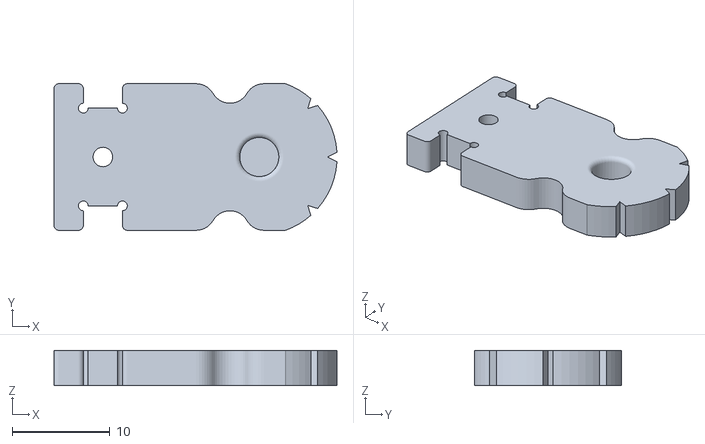
[picture p93: CAD file, 2025-01-12, last stored version]
Reference/mechanism/joint_bottom.STL
28.9 x 15.0 x 3.60
