ParagPat20/Codes/Reference/mechanism/accessory_small_spacer_mg90s.stl

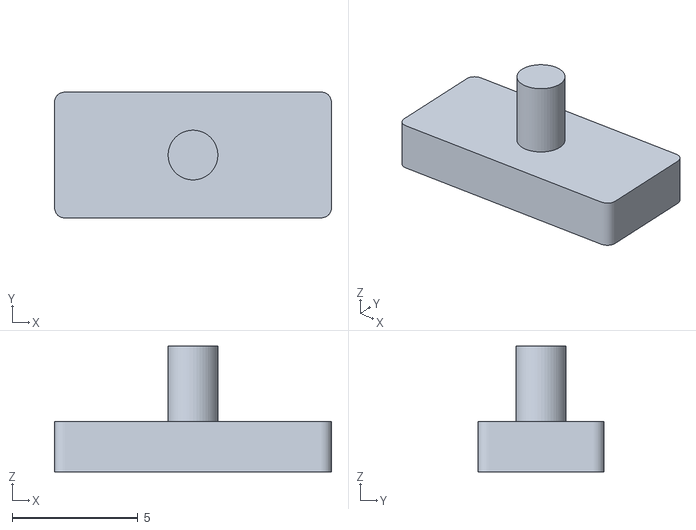
[picture p94: CAD file, 2025-01-12, last stored version]
Reference/mechanism/accessory_small_spacer_mg90s.stl
11.0 x 5.00 x 5.00
