ParagPat20/Codes/(list of files, cad)

Other CAD files:
Reference/mechanism/foot_top_mg92b.STL
Reference/mechanism/joint_top_mg92b.STL
Reference/mechanism/body_servo_side2.STL
