ParagPat20/Codes/Documentation/Tech-Expo-Rules.PDF

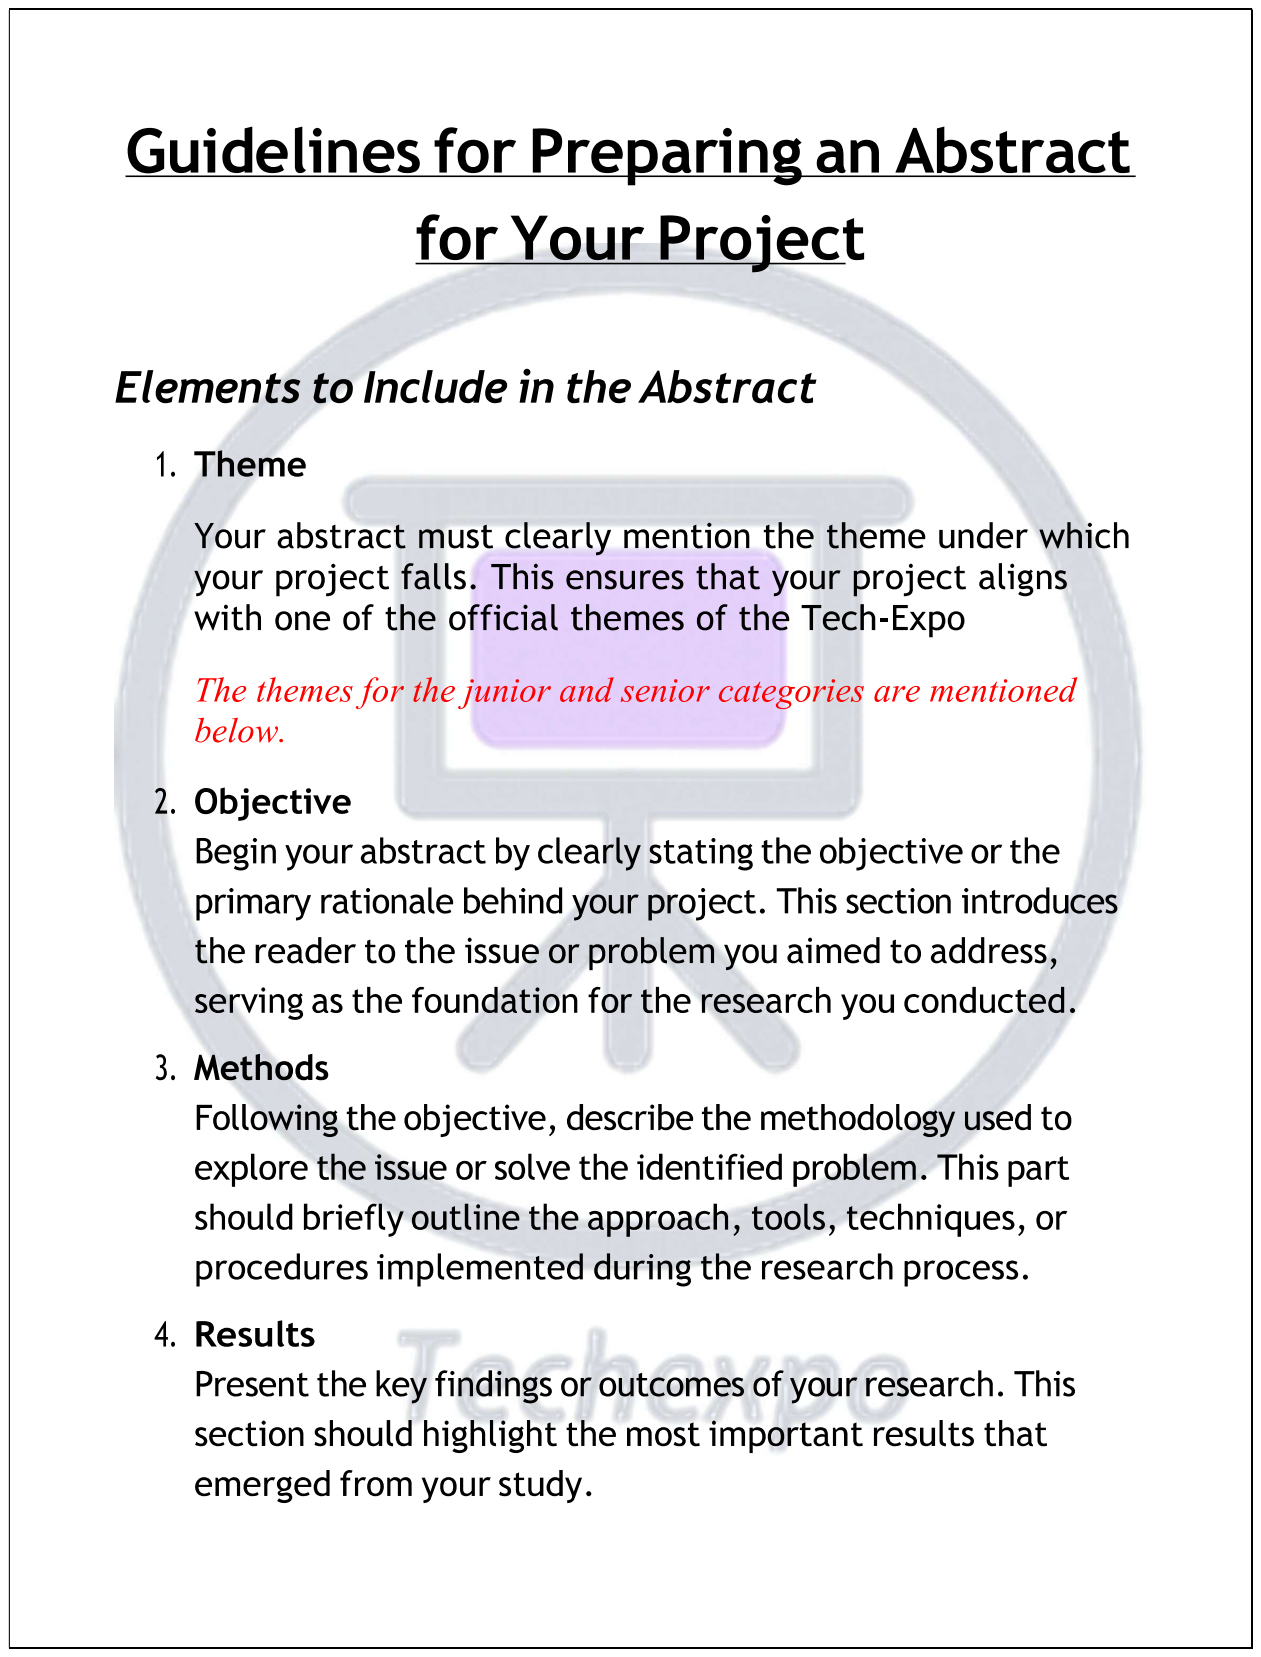
[picture p98: page 1]

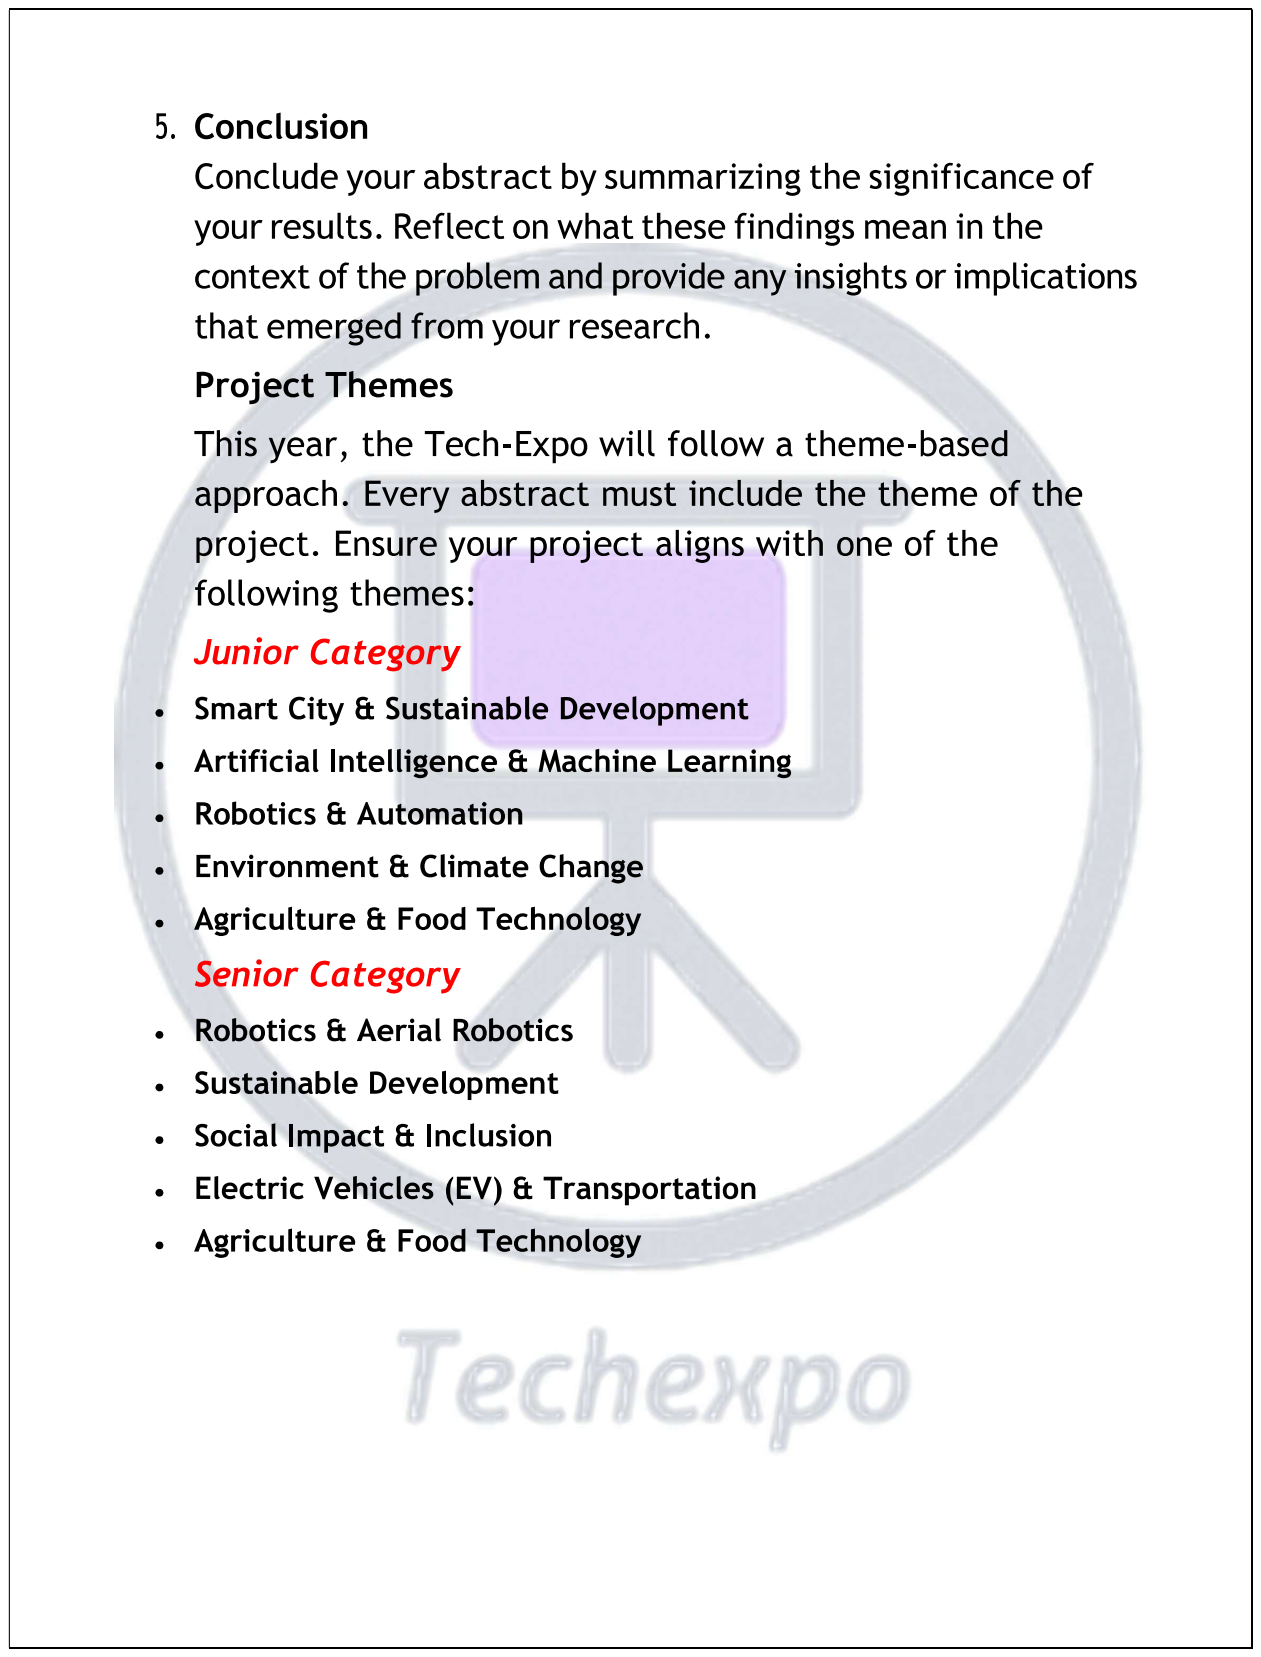
[picture p99: page 2]

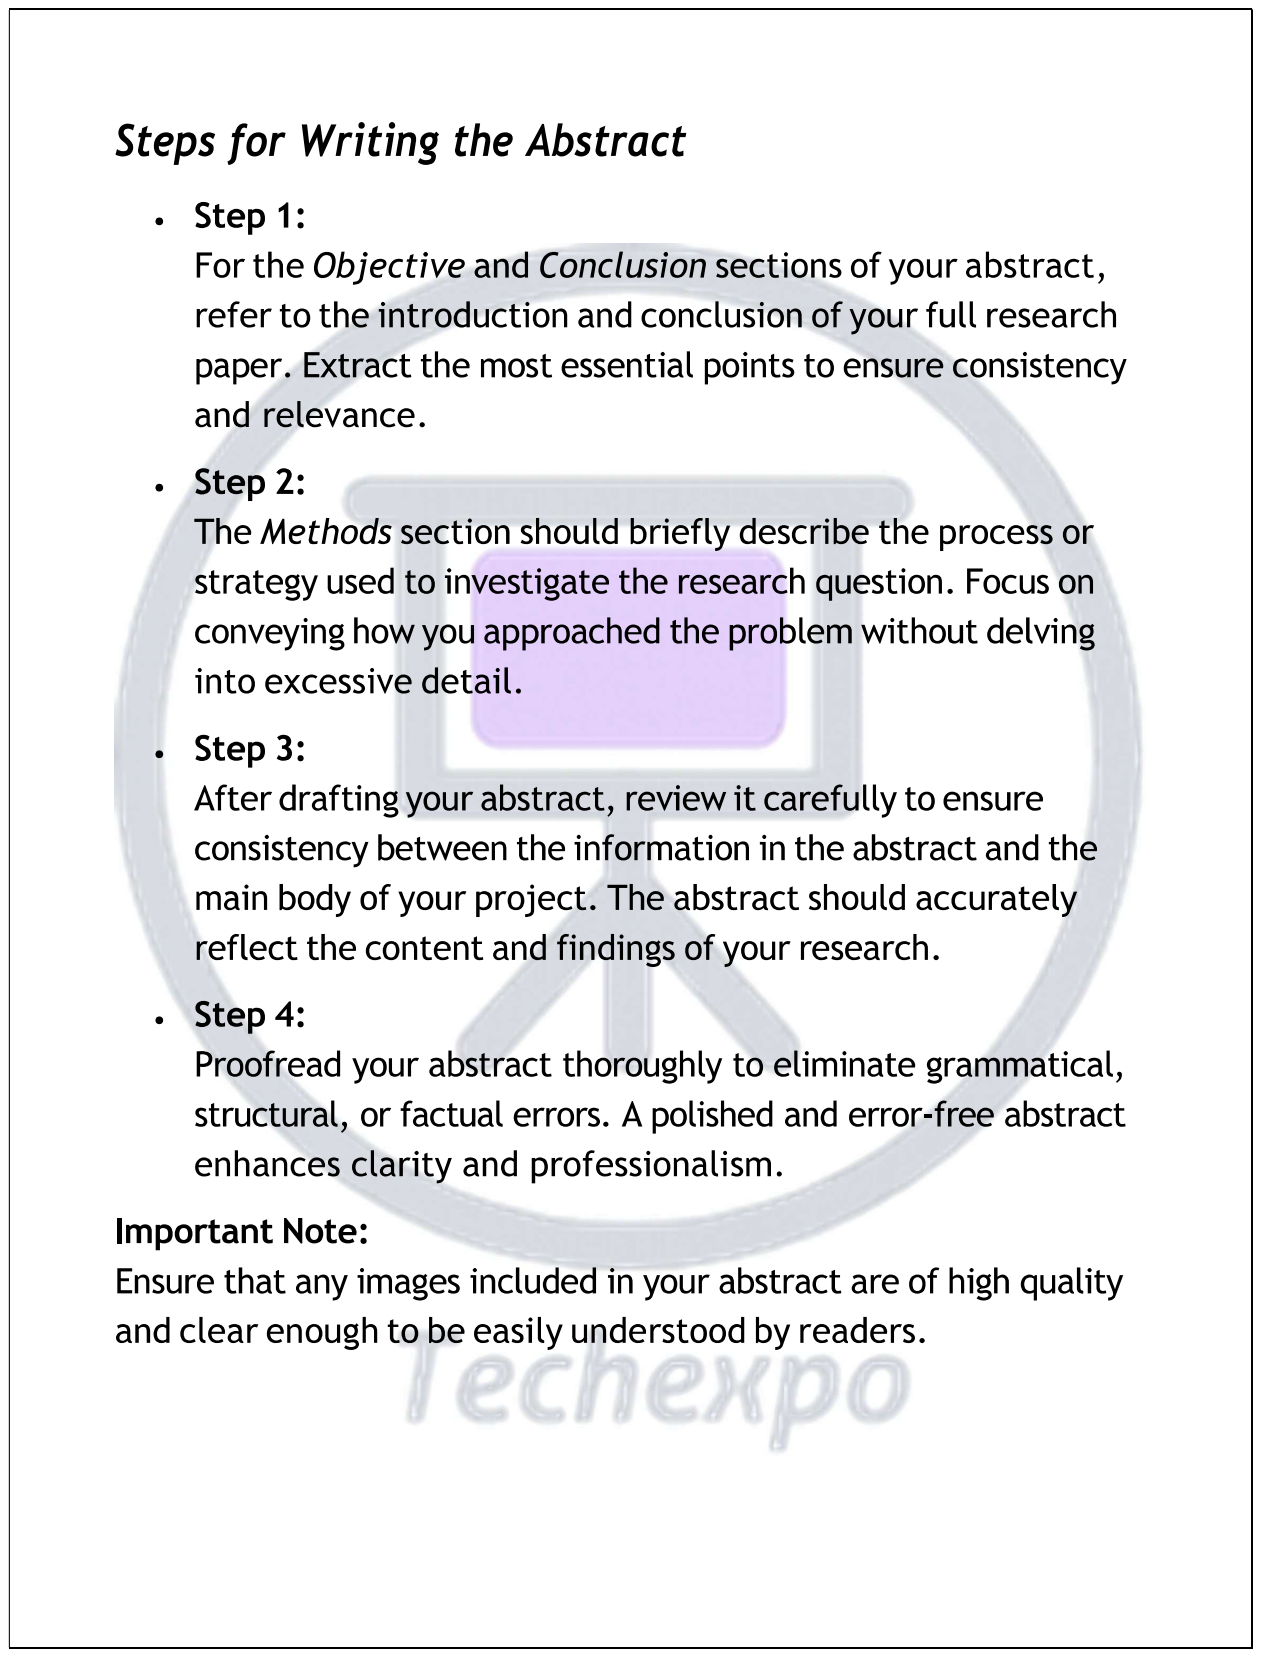
[picture p100: page 3]
