ParagPat20/Codes/Documentation/FrontCLView.pdf

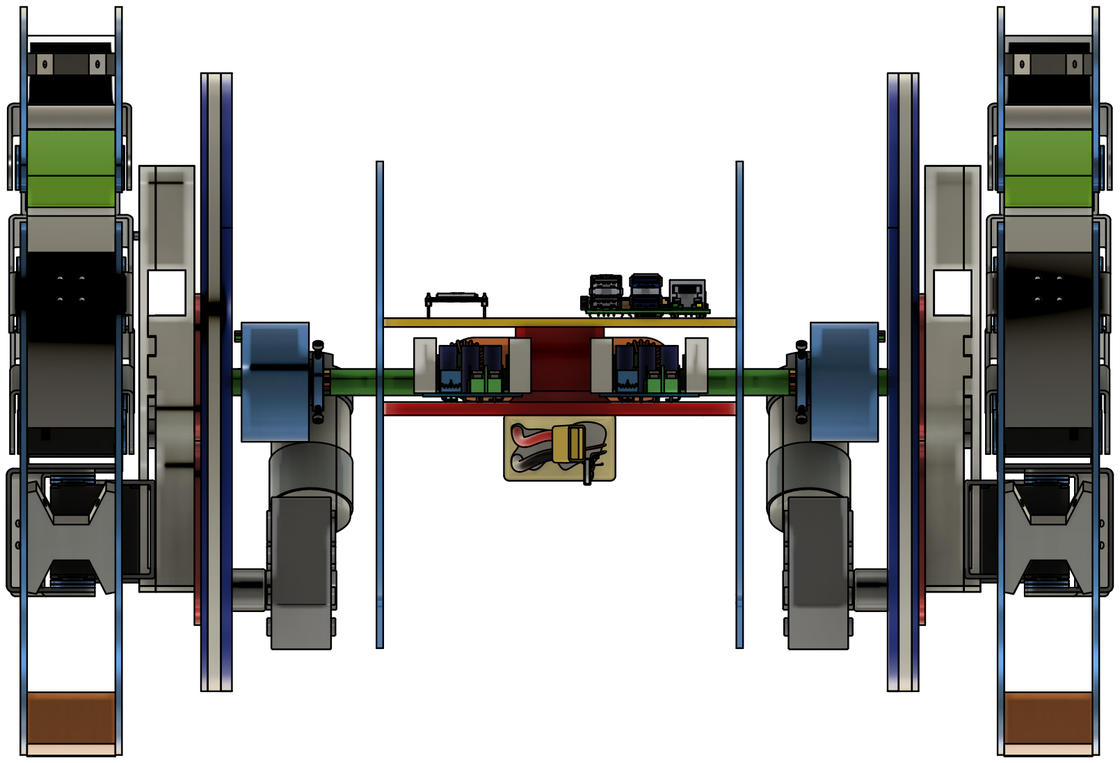
[picture p109: page 1]
