ParagPat20/Codes/Firmware/LCD_1inch69/DEV_Config.cpp

/*****************************************************************************
* | File        :   DEV_Config.c
* | Author      :   Waveshare team
* | Function    :   Hardware underlying interface
* | Info        :   Used to shield the underlying layers of each master and enhance portability
*----------------
* | This version:   V1.0
* | Date        :   2018-11-22
* | Info        :

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
******************************************************************************/
#include "DEV_Config.h"

void GPIO_Init()
{
    pinMode(DEV_CS_PIN, OUTPUT);
    pinMode(DEV_RST_PIN, OUTPUT);
    pinMode(DEV_DC_PIN, OUTPUT);
    pinMode(DEV_BL_PIN, OUTPUT);
    digitalWrite(DEV_BL_PIN, HIGH); // Turn on backlight for ESP32
}

void Config_Init()
{
    //Serial
    Serial.begin(115200);

    // GPIO Init
    GPIO_Init();

    // Hardware SPI on ESP32 (SCK=18, MISO=19, MOSI=23, SS=5)
#if defined(ESP32)
    SPI.begin(18, 19, 23, DEV_CS_PIN);
    SPI.setFrequency(40000000);
    SPI.setDataMode(SPI_MODE3);
    SPI.setBitOrder(MSBFIRST);
#else
    SPI.setDataMode(SPI_MODE3);
    SPI.setBitOrder(MSBFIRST);
    SPI.setClockDivider(SPI_CLOCK_DIV2);
    SPI.begin();
#endif
}
