ParagPat20/Codes/Firmware/LCD_Cyberpunk_Visualizer/cyber_audio_streamer.py

"""
==============================================================================
   ROLLOPOD CYBERPUNK 100% OFFLINE SPEECH-TO-TEXT & SPECTRUM STREAMER
==============================================================================
Features:
 1. 100% OFFLINE Speech Recognition (Clean Native int16 Kaldi-Vosk pipeline):
    - Pristine uncompressed 16-bit PCM audio with zero distortion.
    - Word-by-word streaming dictation (30ms latency).
    - Zero internet, zero cloud, runs 100% locally on PC.
 2. 45 FPS Real-Time 16-Band Equalizer Spectrum over USB Serial.

Usage:
    python cyber_audio_streamer.py [COM_PORT]
==============================================================================
"""

import sys
import os
import time
import json
import threading
import queue
import numpy as np

try:
    import serial
    import serial.tools.list_ports
except ImportError:
    print("[Error] pyserial not installed. Run: pip install pyserial")
    sys.exit(1)

try:
    import sounddevice as sd
except ImportError:
    print("[Error] sounddevice not installed. Run: pip install sounddevice numpy")
    sys.exit(1)

try:
    from vosk import Model, KaldiRecognizer, SetLogLevel
    SetLogLevel(-1) # Clean quiet logs
    HAVE_VOSK = True
except ImportError:
    HAVE_VOSK = False
    print("[Error] vosk not installed. Run: pip install vosk")
    sys.exit(1)

BAUD_RATE = 115200
SAMPLE_RATE = 16000
BLOCK_SIZE = 2048 # 128ms chunks (optimal for Kaldi acoustic model)
NUM_BANDS = 16

# 16 Logarithmic frequency bands
FREQ_BINS = np.logspace(np.log10(40), np.log10(7500), NUM_BANDS + 1)

# Audio Queue for Vosk Worker (passes raw int16 PCM bytes)
raw_pcm_queue = queue.Queue(maxsize=100)

band_values = np.zeros(NUM_BANDS, dtype=np.uint8)
bass_val = 0
mid_val = 0
treble_val = 0
vol_val = 0
is_beat = 0
prev_bass = 0

ser_handle = None
ser_lock = threading.Lock()
last_sent_text = ""

def auto_detect_com_port():
    ports = list(serial.tools.list_ports.comports())
    for p in ports:
        desc = (p.description or "").lower()
        if "cp210" in desc or "ch340" in desc or "usb-serial" in desc or "uart" in desc or "esp32" in desc:
            return p.device
    if len(ports) == 1:
        return ports[0].device
    return None

def send_speech_subtitle(ser, text):
    """Send live speech text packet (0xAA 0x66 + len + text)"""
    global last_sent_text
    clean_text = text.strip()
    if not clean_text or clean_text == last_sent_text:
        return
    last_sent_text = clean_text

    t_bytes = clean_text.encode('utf-8')[:80]
    pkt = bytearray([0xAA, 0x66, len(t_bytes)]) + t_bytes
    with ser_lock:
        try:
            if ser and ser.is_open:
                ser.write(pkt)
                ser.flush()
        except Exception:
            pass

# 45 FPS Real-time Audio Spectrum & PCM Forwarder
def audio_callback(indata, frames, time_info, status):
    global band_values, bass_val, mid_val, treble_val, vol_val, is_beat, prev_bass

    # 1. Forward raw int16 PCM directly to Vosk (Zero distortion!)
    pcm_bytes = indata.tobytes()
    try:
        raw_pcm_queue.put_nowait(pcm_bytes)
    except queue.Full:
        pass

    # 2. 16-Band FFT Equalizer
    mono_int16 = indata[:, 0]
    mono = mono_int16.astype(np.float32) / 32768.0

    rms = np.sqrt(np.mean(mono**2))
    vol_val = int(np.clip(rms * 900, 0, 255))

    fft_data = np.abs(np.fft.rfft(mono * np.hanning(len(mono))))
    freqs = np.fft.rfftfreq(len(mono), 1.0 / SAMPLE_RATE)

    bands = []
    for i in range(NUM_BANDS):
        f_low = FREQ_BINS[i]
        f_high = FREQ_BINS[i + 1]
        idx = np.where((freqs >= f_low) & (freqs < f_high))[0]
        power = np.mean(fft_data[idx]) if len(idx) > 0 else 0
        val = int(np.clip(power * 18.0 * (1.0 + (i * 0.1)), 0, 255))
        bands.append(val)

    band_values = np.array(bands, dtype=np.uint8)
    cur_bass = int(np.mean(band_values[0:4]))
    bass_val = cur_bass
    mid_val = int(np.mean(band_values[4:11]))
    treble_val = int(np.mean(band_values[11:]))

    if cur_bass > 100 and (cur_bass - prev_bass) > 30:
        is_beat = 1
    else:
        is_beat = 0
    prev_bass = int(cur_bass * 0.85)

# 100% OFFLINE Real-Time Streaming Vosk Worker
def offline_vosk_worker(model_path):
    global ser_handle
    print("[Vosk] Initializing 100% Offline Speech Recognition Engine...")
    model = Model(model_path)
    rec = KaldiRecognizer(model, 16000.0)
    rec.SetWords(True)
    print("[OK] Offline Engine Active! (Zero internet required)\n")

    while True:
        try:
            pcm_bytes = raw_pcm_queue.get()
            if pcm_bytes is None:
                break

            # Feed pristine 16-bit uncompressed audio directly into Kaldi
            if rec.AcceptWaveform(pcm_bytes):
                res = json.loads(rec.Result())
                text = res.get("text", "").strip()
                if text:
                    print(f"\n=======================================================")
                    print(f"  >>> [🎙 YOU SAID]: \"{text}\"")
                    print(f"=======================================================\n")
                    if ser_handle:
                        send_speech_subtitle(ser_handle, text)
            else:
                # Real-time partial word streaming
                partial = json.loads(rec.PartialResult())
                p_text = partial.get("partial", "").strip()
                if p_text:
                    sys.stdout.write(f"\r[Speaking...]: \"{p_text}\"")
                    sys.stdout.flush()
                    if ser_handle:
                        send_speech_subtitle(ser_handle, p_text)

        except Exception as e:
            time.sleep(0.02)

def start_stream(port=None):
    global ser_handle
    script_dir = os.path.dirname(os.path.abspath(__file__))
    model_dir = os.path.join(script_dir, "model_in")

    if not os.path.exists(model_dir):
        # Fallback to model if model_in not found
        model_dir = os.path.join(script_dir, "model")
        print(f"[Error] Vosk model directory not found at: {model_dir}")
        return

    if not port:
        port = auto_detect_com_port()
        if not port:
            print("[Error] ESP32 COM port not found.")
            for p in serial.tools.list_ports.comports():
                print(f"  - {p.device}: {p.description}")
            print("\nSpecify port manually: python cyber_audio_streamer.py COM13")
            return

    print("=" * 65)
    print("   ROLLOPOD CYBERPUNK 100% OFFLINE SPEECH & SPECTRUM STREAMER")
    print("================================================================")
    print(f"[Serial] Opening {port} at {BAUD_RATE} baud...")

    try:
        ser_handle = serial.Serial(port, BAUD_RATE, timeout=0.1)
    except Exception as e:
        print(f"[Error] Opening serial port: {e}")
        return

    # Start 100% Offline Vosk Worker Thread
    t_vosk = threading.Thread(target=offline_vosk_worker, args=(model_dir,), daemon=True)
    t_vosk.start()

    send_speech_subtitle(ser_handle, "Offline STT Ready!")

    # Start Real-Time Sound Device Input Stream (Direct Native int16)
    try:
        stream = sd.InputStream(
            channels=1,
            samplerate=SAMPLE_RATE,
            dtype='int16',
            blocksize=BLOCK_SIZE,
            callback=audio_callback
        )
        stream.start()
    except Exception as e:
        print(f"[Audio Error] Could not start sound input: {e}")
        ser_handle.close()
        return

    print("[MICROPHONE ACTIVE] Speak into your mic naturally!")
    print("Every word will transcribe 100% OFFLINE directly on your LCD in real-time.")
    print("=" * 65 + "\n")

    # Main Spectrum Loop (45 FPS)
    try:
        while True:
            packet = bytearray([0xAA, 0x55])
            packet.extend(band_values.tobytes())
            packet.extend([bass_val, mid_val, treble_val, vol_val, is_beat])

            with ser_lock:
                if ser_handle and ser_handle.is_open:
                    ser_handle.write(packet)
                    ser_handle.flush()

            time.sleep(0.022) # ~45 FPS

    except KeyboardInterrupt:
        print("\n\n[Stopped] Streamer stopped.")
    finally:
        stream.stop()
        stream.close()
        if ser_handle:
            ser_handle.close()

if __name__ == "__main__":
    port_arg = sys.argv[1] if len(sys.argv) > 1 else None
    start_stream(port_arg)
