ParagPat20/Codes/Firmware/RollopodCodes/ESP32_Firmware/esp32_espnow_test_receiver/esp32_espnow_test_receiver.ino

#include <esp_now.h>
#include <WiFi.h>

// Structure to receive data (Must match sender structure)
typedef struct struct_message {
    char a[32];
    int b;
    float c;
    bool d;
} struct_message;

struct_message myData;

// Callback function that will be executed when data is received
void OnDataRecv(const esp_now_recv_info *recvInfo, const uint8_t *incomingData, int len) {
  memcpy(&myData, incomingData, sizeof(myData));
  Serial.print("Bytes received: ");
  Serial.println(len);
  Serial.print("Char: ");
  Serial.println(myData.a);
  Serial.print("Int: ");
  Serial.println(myData.b);
  Serial.print("Float: ");
  Serial.println(myData.c);
  Serial.print("Bool: ");
  Serial.println(myData.d);
  Serial.println();
}
 
void setup() {
  // Initialize Serial Monitor
  Serial.begin(115200);
  
  // Set device as a Wi-Fi Station
  WiFi.mode(WIFI_STA);

  // Init ESP-NOW
  if (esp_now_init() != ESP_OK) {
    Serial.println("Error initializing ESP-NOW");
    return;
  }
  
  // Register callback to receive data
  esp_now_register_recv_cb(OnDataRecv);
}
 
void loop() {
  
}
