ParagPat20/Codes/Firmware/RollopodCodes/ESP32_Firmware/esp32_espnow_test_sender/esp32_espnow_test_sender.ino

#include <esp_now.h>
#include <WiFi.h>

// MAC Address of the Slave ESP32 (Receiver)
uint8_t broadcastAddress[] = {0x84, 0x1F, 0xE8, 0x2B, 0x52, 0x60};
esp_now_peer_info_t peerInfo;

// Structure to send data (Must match receiver structure)
typedef struct struct_message {
  char a[32];
  int b;
  float c;
  bool d;
} struct_message;

struct_message myData;


// Callback when data is sent
void OnDataSent(const wifi_tx_info_t *info, esp_now_send_status_t status) {
  Serial.print("\r\nLast Packet Send Status:\t");
  Serial.println(status == ESP_NOW_SEND_SUCCESS ? "Delivery Success" : "Delivery Fail");
}
 
void setup() {
  // Init Serial Monitor
  Serial.begin(115200);
 
  // Set device as a Wi-Fi Station
  WiFi.mode(WIFI_STA);

  // Init ESP-NOW
  if (esp_now_init() != ESP_OK) {
    Serial.println("Error initializing ESP-NOW");
    return;
  }

  // Register peer status callback
  esp_now_register_send_cb(OnDataSent);
  
  // Register peer
  memcpy(peerInfo.peer_addr, broadcastAddress, 6);
  peerInfo.channel = 0;  
  peerInfo.encrypt = false;
  
  // Add peer        
  if (esp_now_add_peer(&peerInfo) != ESP_OK){
    Serial.println("Failed to add peer");
    return;
  }
}
 
void loop() {
  // Set values to send
  strcpy(myData.a, "THIS IS A TEST PING");
  myData.b = random(1, 100);
  myData.c = 1.23;
  myData.d = false;
  
  // Send message via ESP-NOW
  esp_err_t result = esp_now_send(broadcastAddress, (uint8_t *) &myData, sizeof(myData));
   
  if (result == ESP_OK) {
    Serial.println("Sent with success");
  }
  else {
    Serial.println("Error sending the data");
  }

  delay(2000);
}
