ParagPat20/Codes/(commit log)

2025-01-12 Refactor hexapod control system: Updated servo configurations, enhanced motion control logic, and improved GUI layout. Removed obsolete RPI config file. Added functionality for motion commands and se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
    [accessory_cable_holder.STL, accessory_small_spacer_mg90s.stl, accessory_spacer_mg90s.STL, body_base.STL, body_battery.STL, body_front_back.STL, body_servo_side1.STL, body_servo_side2.STL]
2025-01-12 Refactor serial connection setup in main.py: Implemented dynamic port scanning for Arduino connections, enhancing robustness by attempting multiple USB and ACM ports before establishing a connection.
2025-02-16 Create BatteryConnections
2026-08-06 feat: implement ESP32 master-slave bridge via ESP-NOW for wireless serial communication
2026-08-06 feat: implement ESP-NOW serial bridge for communication between ESP32 master and PCA9685 slave units
2026-08-09 refactor: reorganize project structure, migrate firmware components, and update documentation assets.
    [CostSheets (1).xlsx, CostSheets.xlsx]
2026-08-13 feat: initialize project firmware structure, controller GUI, and MPU6050 visualization tools
    [rollopod_servo_profile.json]
2026-08-19 feat(gui): update controller GUI layout, standing pose persistence, and mechanical structure docs
    [rollopod_servo_profile.json]
2026-08-23 Add .gitignore for ESP32-S3-CAM-OVxxxx
2026-08-23 Update firmware with Encoder PID, Waddling Generator GUI & Mechanical docs
    [partitions.csv, rollopod_servo_profile.json]
2026-08-23 Fix string literal newline escapes in ESP32 Slave firmware files
    [L_ESP32_SLAVE.ino, R_ESP32_SLAVE.ino, esp32_slave_pca9685.ino]
2026-08-23 Update GUI and slave firmware to transmit RPM commands instead of PWM
2026-08-23 Fix startup motor spinning by correcting speed==0 DIR pin state and adding PID position hold deadband
    [L_ESP32_SLAVE.ino, R_ESP32_SLAVE.ino, esp32_slave_pca9685.ino]
2026-08-23 feat: add ESP32-C6 slave firmware for PCA9685 control, closed-loop motor PID, and Python GUI servo management
2026-08-27 Rutu ne kiya he
    [rollopod_servo_profile.json]
2026-08-27 feat: add GUI joystick controller and dual ESP32 slave firmware for Rollopod systems
